akouz/HBus/HBnodeMiniPro/README.md

# Demo HBus implementation for Arduino Mini Pro

Current firmware revision 1.5 uses 69% of flash and 56% of SRAM. The demo code has 4 topics and 4 coos tasks as defined in "HBconfig.h". Development notes in "HBcommon.h".
