akouz/HBus/Devices/README.md

# HBus Devices

Power supply should be in the range 9...30V. Devices designed for +12V, but they can work from +24V supply too.

  * [Fuse](https://github.com/akouz/HBus/tree/master/Devices/01_Fuse)
  * [USB Bridge](https://github.com/akouz/HBus/tree/master/Devices/02_USB_Bridge) 
    * PC program [NodeTest](https://github.com/akouz/HBus/tree/master/NodeTest)
  * [2.1] [WiFi Gateway](https://github.com/akouz/HBus/tree/master/Devices/03_WiFi_Gateway)
    * Sketch [WiFiGw](https://github.com/akouz/HBus/tree/master/Devices/03_WiFi_Gateway/WiFiGw)
  * [3.1] [Sensor Input](https://github.com/akouz/HBus/tree/master/Devices/04_Sensor)
  * [4.1] [4-channel Relay Output](https://github.com/akouz/HBus/tree/master/Devices/05_Relay4)
  * [4.2] [4-channel N-MOSFET Output](https://github.com/akouz/HBus/tree/master/Devices/06_MOSFET4)
    * Sketch [White_LED_strip](https://github.com/akouz/HBus/tree/master/Devices/06_MOSFET4/Sketches/White_LED_strip)
  * [5.1] [Power Meter](https://github.com/akouz/HBus/tree/master/Devices/07_Power_Meter)
    * Sketch [Sole_Power_Meter](https://github.com/akouz/HBus/tree/master/Devices/07_Power_Meter/Sole_Power_Meter)
    * Sketch [HBus_Power_Meter](https://github.com/akouz/HBus/tree/master/Devices/07_Power_Meter/HBus_Power_Meter)
  * [5.2] [PIR Sensor Input with 3-channel P-MOSFET Output](https://github.com/akouz/HBus/tree/master/Devices/08_PIR_Sensor)
    * Sketch [PIR Sensor](https://github.com/akouz/HBus/tree/master/Devices/08_PIR_Sensor/PIR_Sensor)
