akouz/HBus/Devices/01_Fuse/README.md

# HBus Fuse

HBus Fuse prevents fire caused by HBus wiring. Cat5/Cat6 cables cannot safely and reliably handle current more than 3.5 A.  HBus Fuse allows a high output current power supply or a 12V battery to be connected to HBus network.

HBus Fuse has 1 input from a 12V power supply or battery, and it has 2 outputs to HBus wiring. It has 2 fuseholders for 20x5 mm fuses. Slow blow 3 A fuses are recommended. When a fuse is blown, a red LED goes lit to indicate a problem.

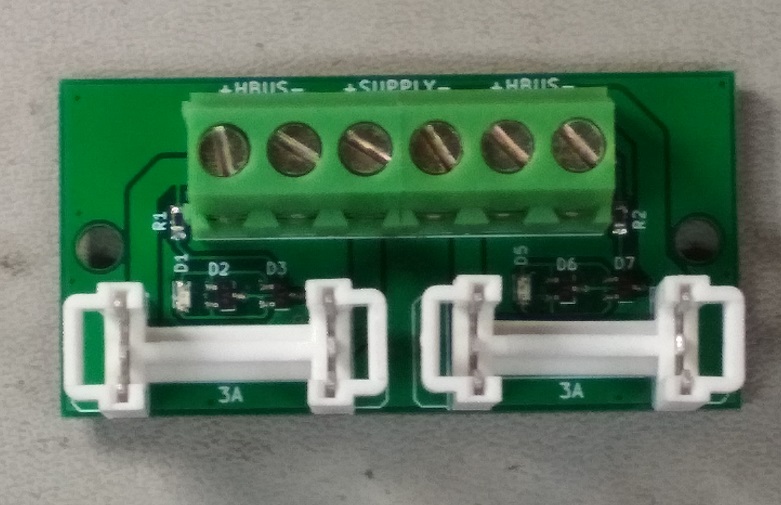
[picture p3: Devices/01_Fuse/Fuse.jpg]
Fuse_board


Assembled board.
