akouz/HBus/Devices/08_PIR_Sensor/README.md

 # HBus PIR Sensor
 
   * PIR sensor HC-SR501, or microwave radar sensor RCWL-0516, or both
   * LDR for ambient light level measurement
   * Optional 1-Wire for temperature sensors
   * Outputs:
     * 3-channel P-MOSFET output for RGB-strips with PWM control
     * Channel 1 output also can drive RGB strips with individial RGB LED control (FastLED, etc)
   * Double sided PCB 50x50 mm

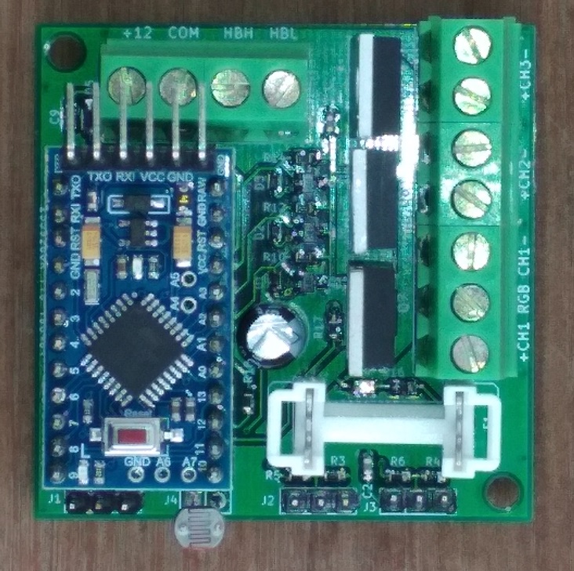
[picture p4: Devices/08_PIR_Sensor/PIR_sensor.jpg]
Assembled


Assembled board.
