akouz/HBus/Devices/06_MOSFET4/README.md

# 4-channel MOSFET Output

  * 4 galvanically isolated outputs, IRF540 MOSFETs
  * MOSFET output designed for 1 kHz PWM
  * Output supply voltage 10...30 Vdc
  * Arduino detects presence of MOSFET supply voltage
  * Optional photoresistor input for ambient light sensing
  * Optional 1-Wire bus for DS18B20 temperature sensors; also this input can be used to connect PIR detector or reed switch
  * Double sided PCB 50x70 mm

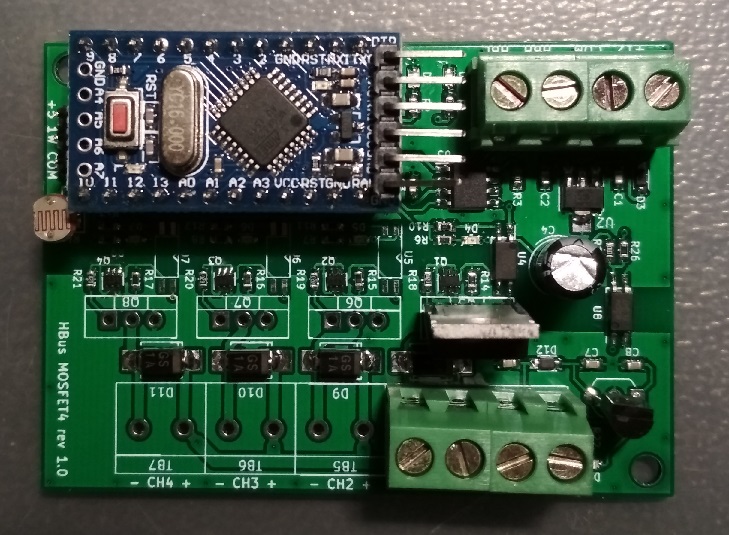
[picture p11: Devices/06_MOSFET4/MOSFET4.jpg]


Board with only one channel CH1 assembled.
