akouz/HBus/Devices/05_Relay4/README.md

# HBus 4-channel Relay

  * 4 channel relay module, current rating 10 A per channel
  * Current transformer input to control state of one load
  * Mains input to control presense of mains voltage, as well as to switch relays close to mains zero-crossing 
  * Relay test input for calibration relay ON/OFF time
  * PCB 85x100 mm with provisions for [DIN rail clips](https://www.ebay.com.au/sch/i.html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)
  
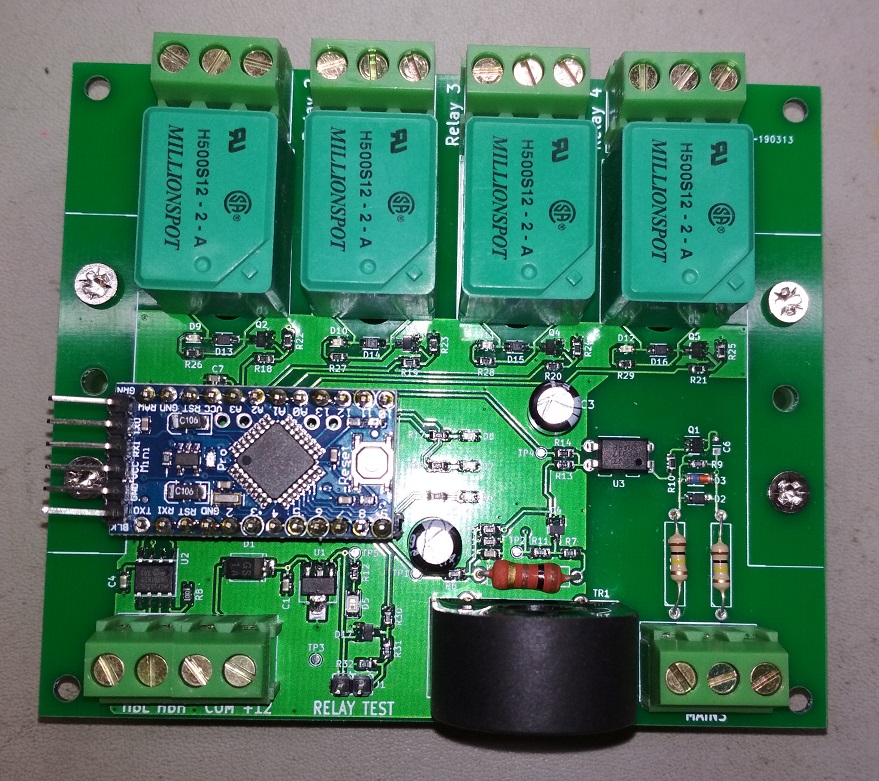
[picture p12: Devices/05_Relay4/Relay4.jpg]
Assembled Relay4
