akouz/HBus/Devices/04_Sensor/README.md

# HBus Sensor

A universal HBus sensor module for various applications. It includes:
  * 1-Wire bus for Dallas DS18S20 temperature sensors.
  * Temperature/humidity/pressure sensor BME280, or any other I2C sensor powered by 3.3V.
  * Four inputs for resistive sensors, such as:
    * [precision interchangeable NTC thermistors](https://www.littelfuse.com/products/temperature-sensors/leaded-thermistors/interchangeable-thermistors/standard-precision-pt/pt222j2.aspx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)
    * photoresistors
    * soil moisture sensors
    * water leakage sensors
    * intrusion detectors 
    * etc

Double sided PCB 50x50 mm.
