akouz/HBus/Devices/07_Power_Meter/HBus_Power_Meter/README.md

# Sketch HBus Power Meter
#### rev 1.0

Measures total household power (import/export) and power produced by solar station. Results output to 1m long RGB LED strip and broadcasted to HBus.
