akouz/HBus/Devices/03_WiFi_Gateway/WiFiGw/README.md

# Sketch WiFiGw.ino

Current rev 1.10

## Encryption

File "cipher.h" generated by [NodeTest](https://github.com/akouz/HBus/tree/master/NodeTest), it stores flash keys. EEPROM keys  and unencrypted access rights should be set by NodeTest during initialisation (command SECURITY, see [HBus protocol](https://github.com/akouz/HBus/tree/master/Protocol)).

## WiFi connection

In WiFi_Gateway.ino enter your WiFi network credentials:

> const char* ssid     = "your_ssid";

> const char* password = "your_password";

In case of lost WiFi connection, sketch tries to restore it, see **coos_task_wifi_reconnect()**.

## MQTT broker

In WiFi_Gateway.ino enter MQTT broker credentials:

> const char* mqtt_url = "your_mqtt_broker";

> const char* mqtt_username = "";

> const char* mqtt_password = "";

If user name or password left blank then Gateway will not use them.

In case of lost connection, sketch will try to re-connect to MQTT broker, see **coos_task_mqtt_reconnect()**.

Sketch keeps MQTT connection alive by sending a short message to broker every 5 sec, see **coos_task_mqtt_ping()**.

## MQTT-SN to MQTT conversion

Gateway reads HBus MQTT-SN messages from the bus, converts them into MQTT messages and sends to the MQTT broker, see **hbus_msg_to_mqtt()** in **HBus.cpp**. Duiring conversion Gateway replaces **TopicId** by a topic name. 

The topic name of the outgoing message consists of **topic_base** and **TopicName**. List of registered **TopicId**s stored in EEPROM, list of registered **TopicName**s stored in SPIFFS. 

For example,  lets assume **topic_base**="HBus",  **TopicName**="topic0" is registered as **TopicId**=100 (or 0x0064). If a node broadcasts  HBus message **PUBLISH**:

> 0C 00 11 00 64 0E 7B 01  {val:3} 

then Gateway converts it to MQTT message with payload **{val:3}** and topic name "**HBus/topic0**" and sends it to the broker.

## MQTT to MQTT-SN conversion

Gateway is subscribed to topics **topic_base**/#. Messages from MQTT broker to that topic will be processed as follows:
  * **topic_base** and "/" removed
  * if the remining **TopicName** is registered by Gateway then corresponding **TopicId** is used to make MQTT-SN message
  * resulting MQTT-SN message broadcasted to HBus

HBus nodes must register their **TopicName**s using **REGISTER** messages, see [HBus protocol](https://github.com/akouz/HBus#mqtt-sn-mode-broadcast-messages). Gateway detects **REGISTER** messages and automaticaly updates its list of registered **NodeName - NodeId** pairs.

## Time service

Every hour sketch requests time from a NTP server. When respond received,  Gateway broadcasts HBus a MQTT-SN message to the default TopicId=1 and sends a message to MQTT broker with default TopicName="time" and with the following payload (sample):

> {atime:1558391178, tz:570, daysec:28578, hr:7, min:56}

where 
  * atime - UTC time, seconds since 00:00:00 of 01/01/2001
  * tz - time zone, offset in minutes from UTC
  * daysec - second since 00:00:00 of current day
  * hr - hour of the day
  * min - minute of the hour

## HBus voltage

Gateway regularly measures HBus supply voltage and sends results to MQTT topic **hb/volt** and to HBus

## CO2 sensor MH-Z19B

Sensor powered by +5V rail. Sensor PWM output connected to D13 (eg GPIO13, Wemos D1 pin 7). After power-up Gateway takes no measurements for 1 min. Gateway outputs measured CO2 level (in ppm) to topic **gw/CO2**

## BMx280 sensor

BMP280 or BME280 sensor connected via I2C bus (SCL=D5, SDA=D4). If connected, sketch broadcasts sensor results to the following MQTT and HBus topics:
  * **gw/temp** - temperature, C
  * **gw/press** - atmospheric pressure, mbar
  * **gw/hum** - relative humidity, % (only if BME280 connected)
  
## OLED display

Sketch outputs harware and software revision, current connecion status data and measurement results via I2C to a 128x32 OLED display driven by SSD1306.
