akouz/HBus/NodeTest/Doc/pic3_1.png

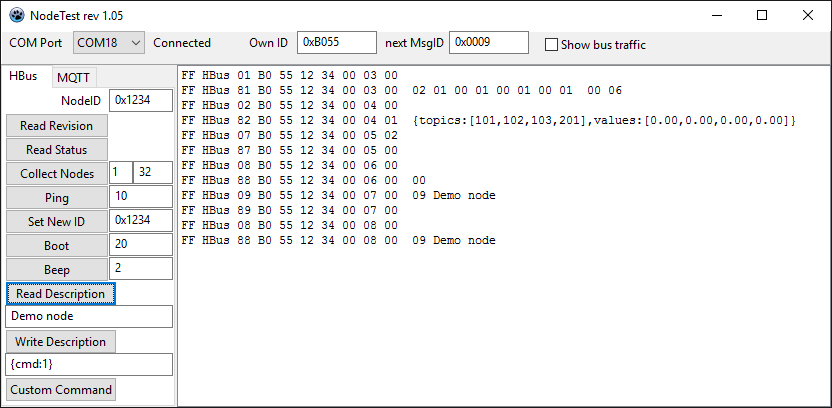
NodeTest/Doc/pic3_1.png
