akouz/HBus/NodeTest/Doc/pic4_1.png

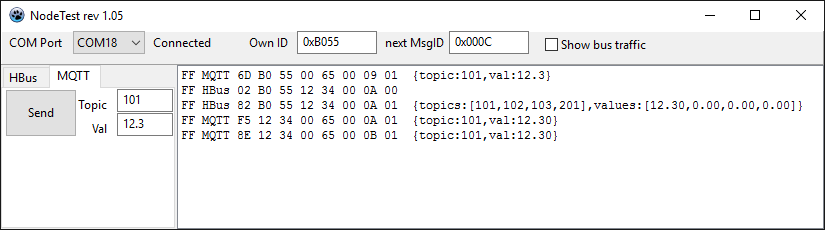
NodeTest/Doc/pic4_1.png
