akouz/HBus/Devices/03_WiFi_Gateway/WiFi_Gateway_SCH_rev_1_4.pdf

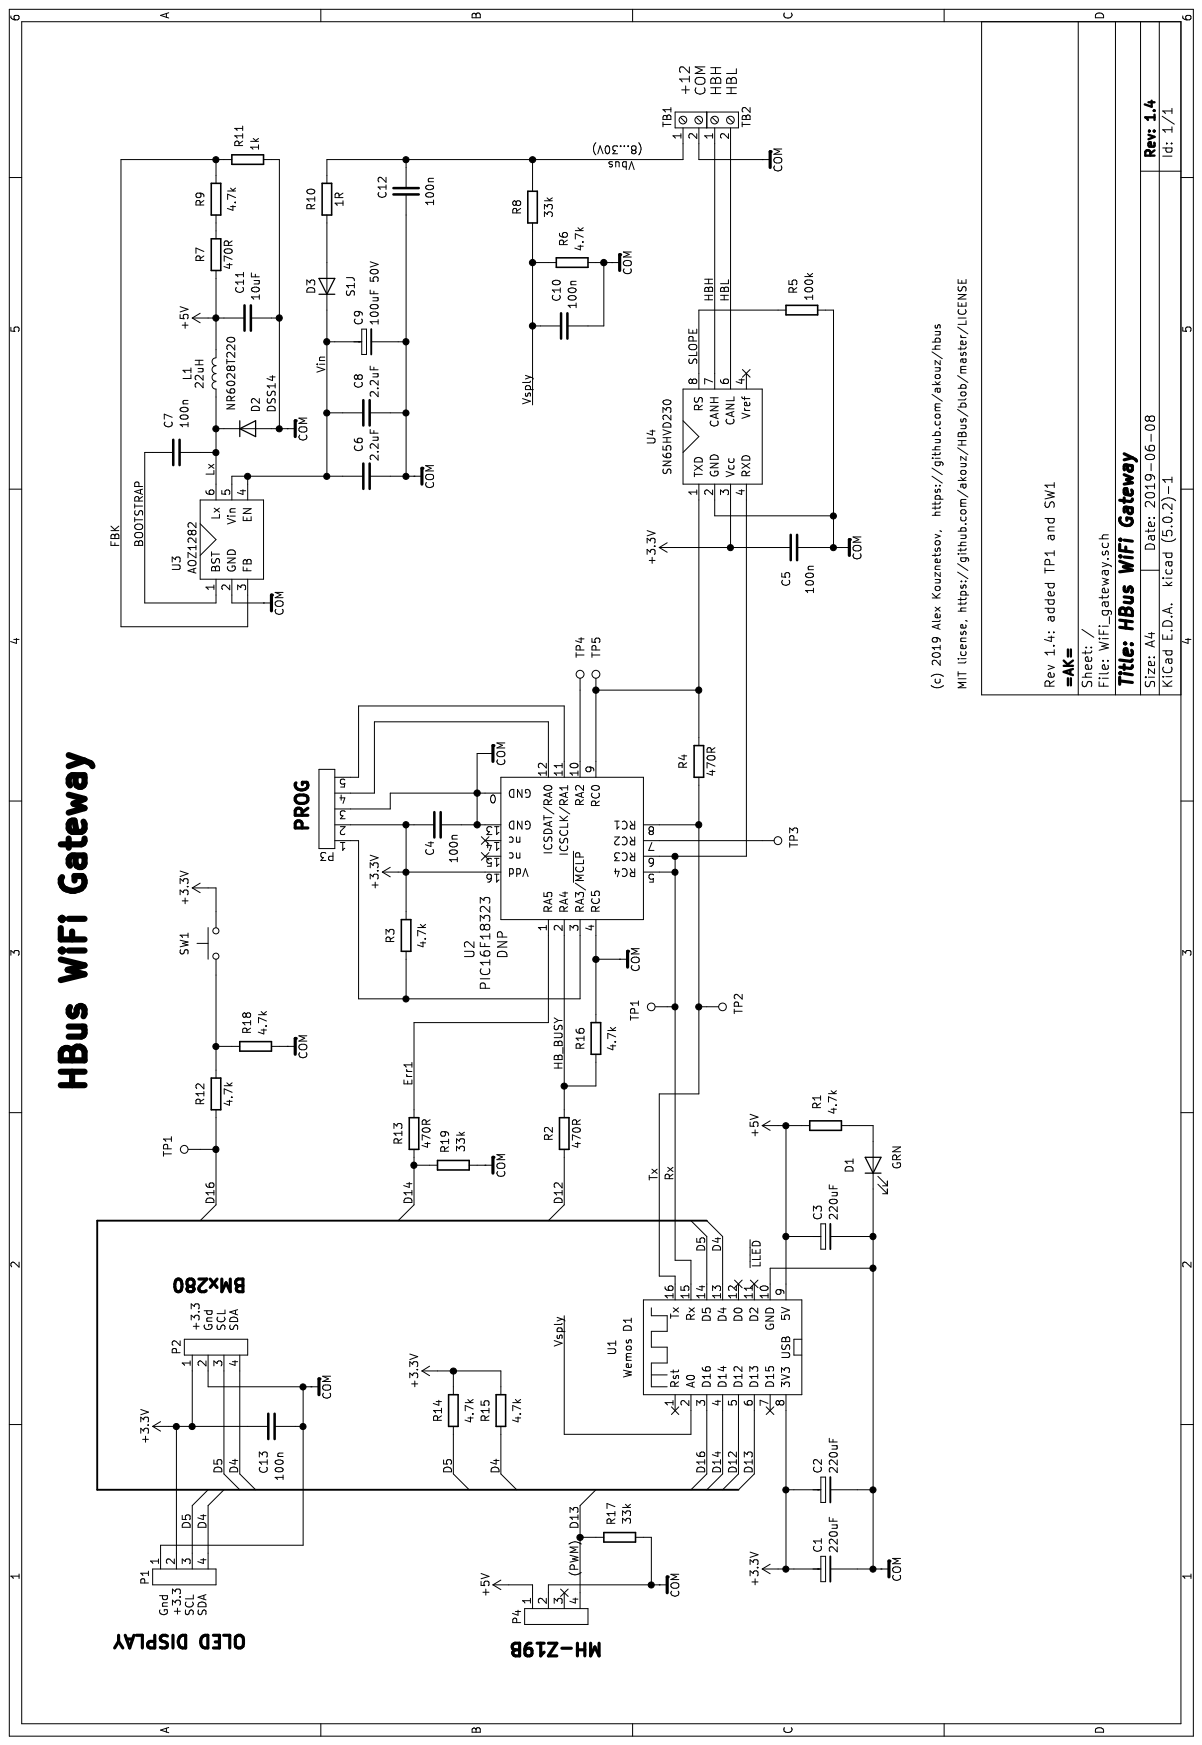
[picture p20: page 1]
