akouz/HBus/Devices/08_PIR_Sensor/PIR_Sensor_SCH_rev_1_1.pdf

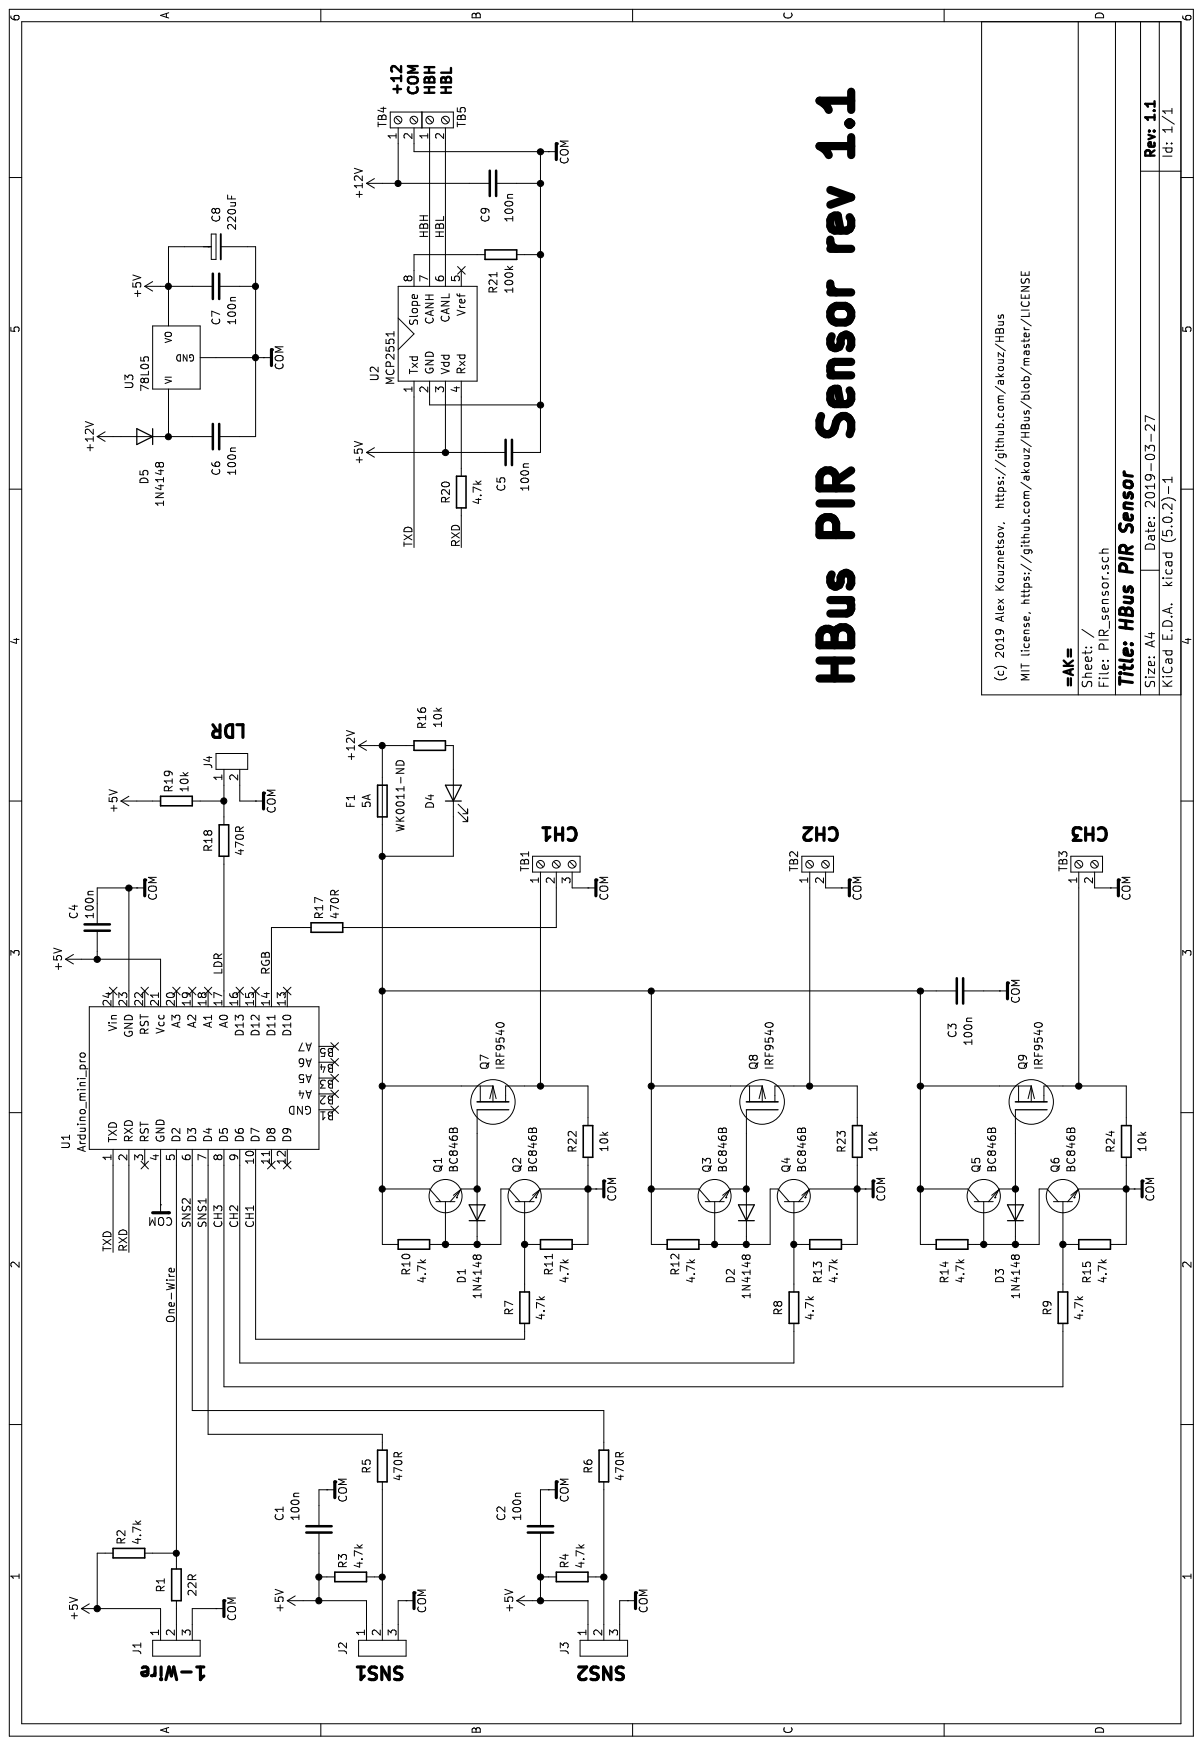
[picture p21: page 1]
