akouz/HBus/Devices/01_Fuse/Fuse_SCH_rev_1_0.pdf

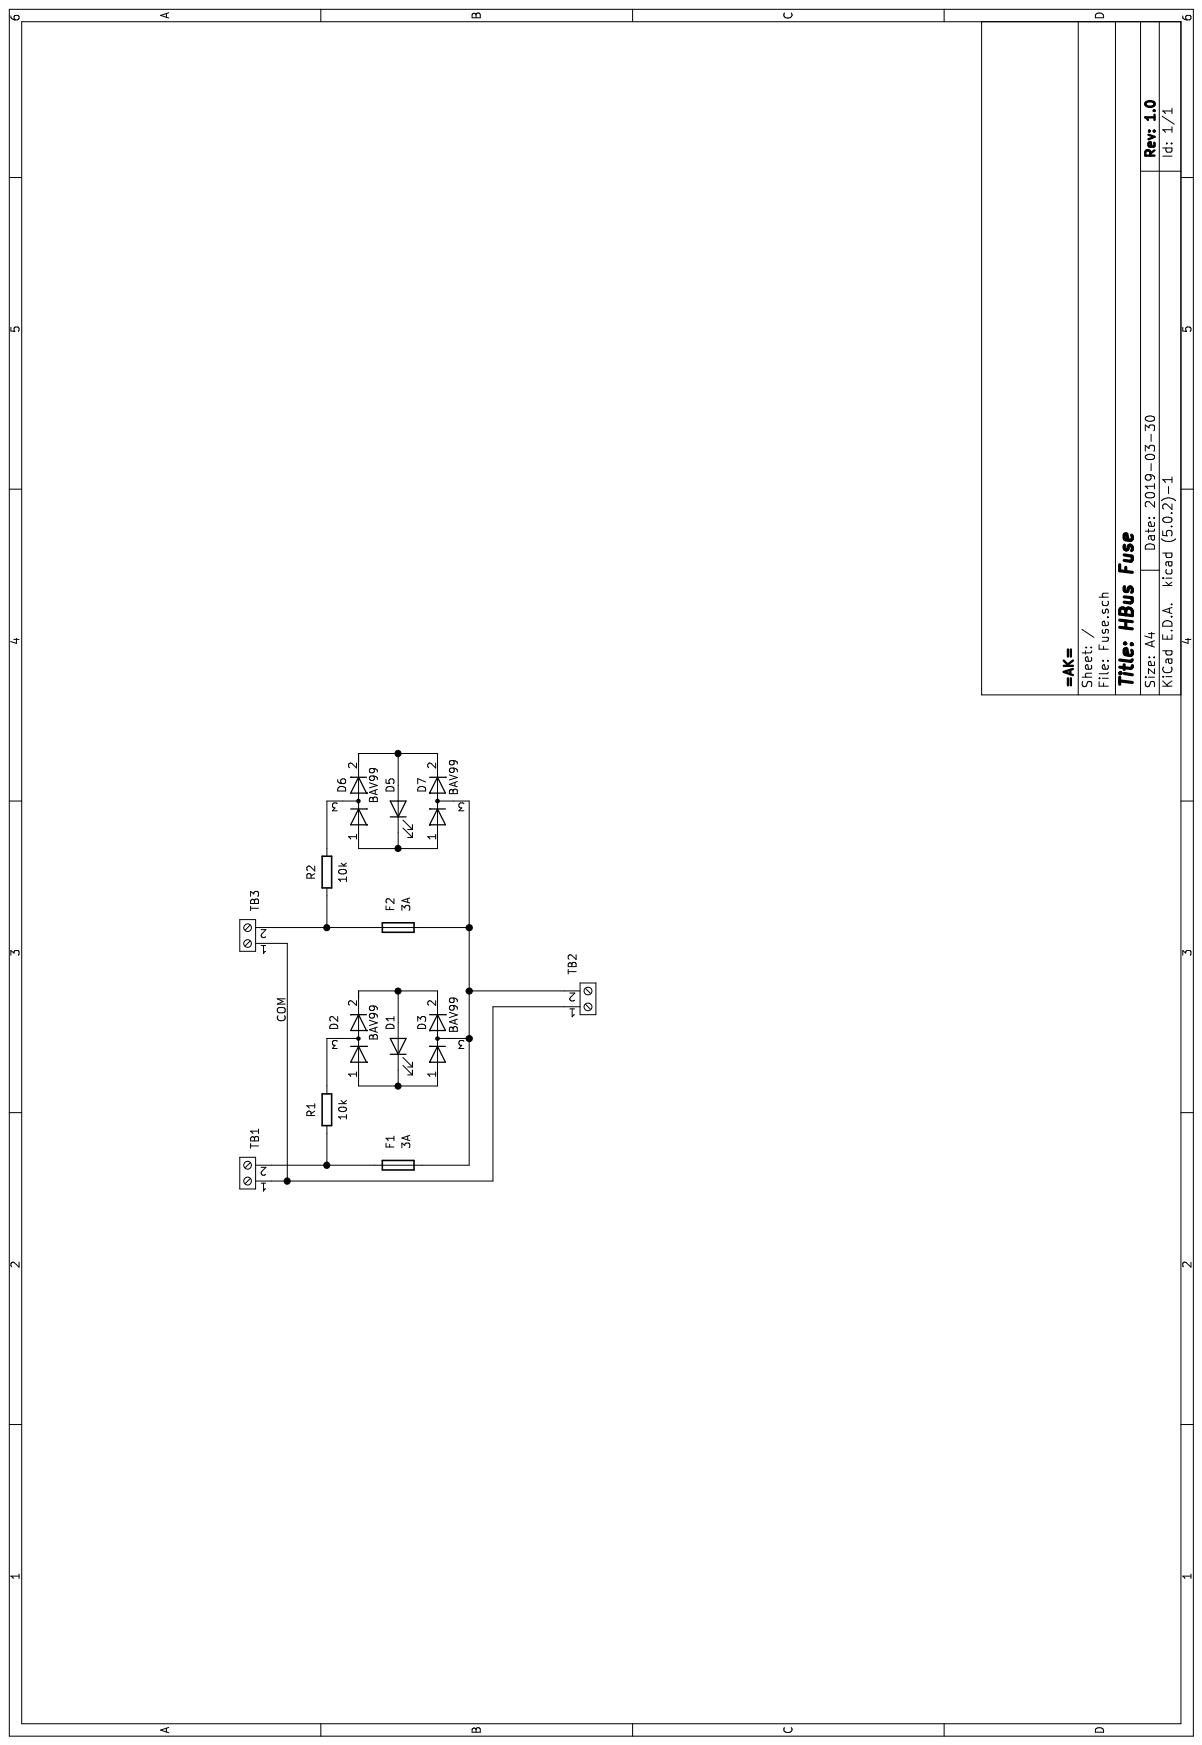
[picture p22: page 1]
