akouz/HBus/Devices/06_MOSFET4/MOSFET4_SCH_rev_1_0.pdf

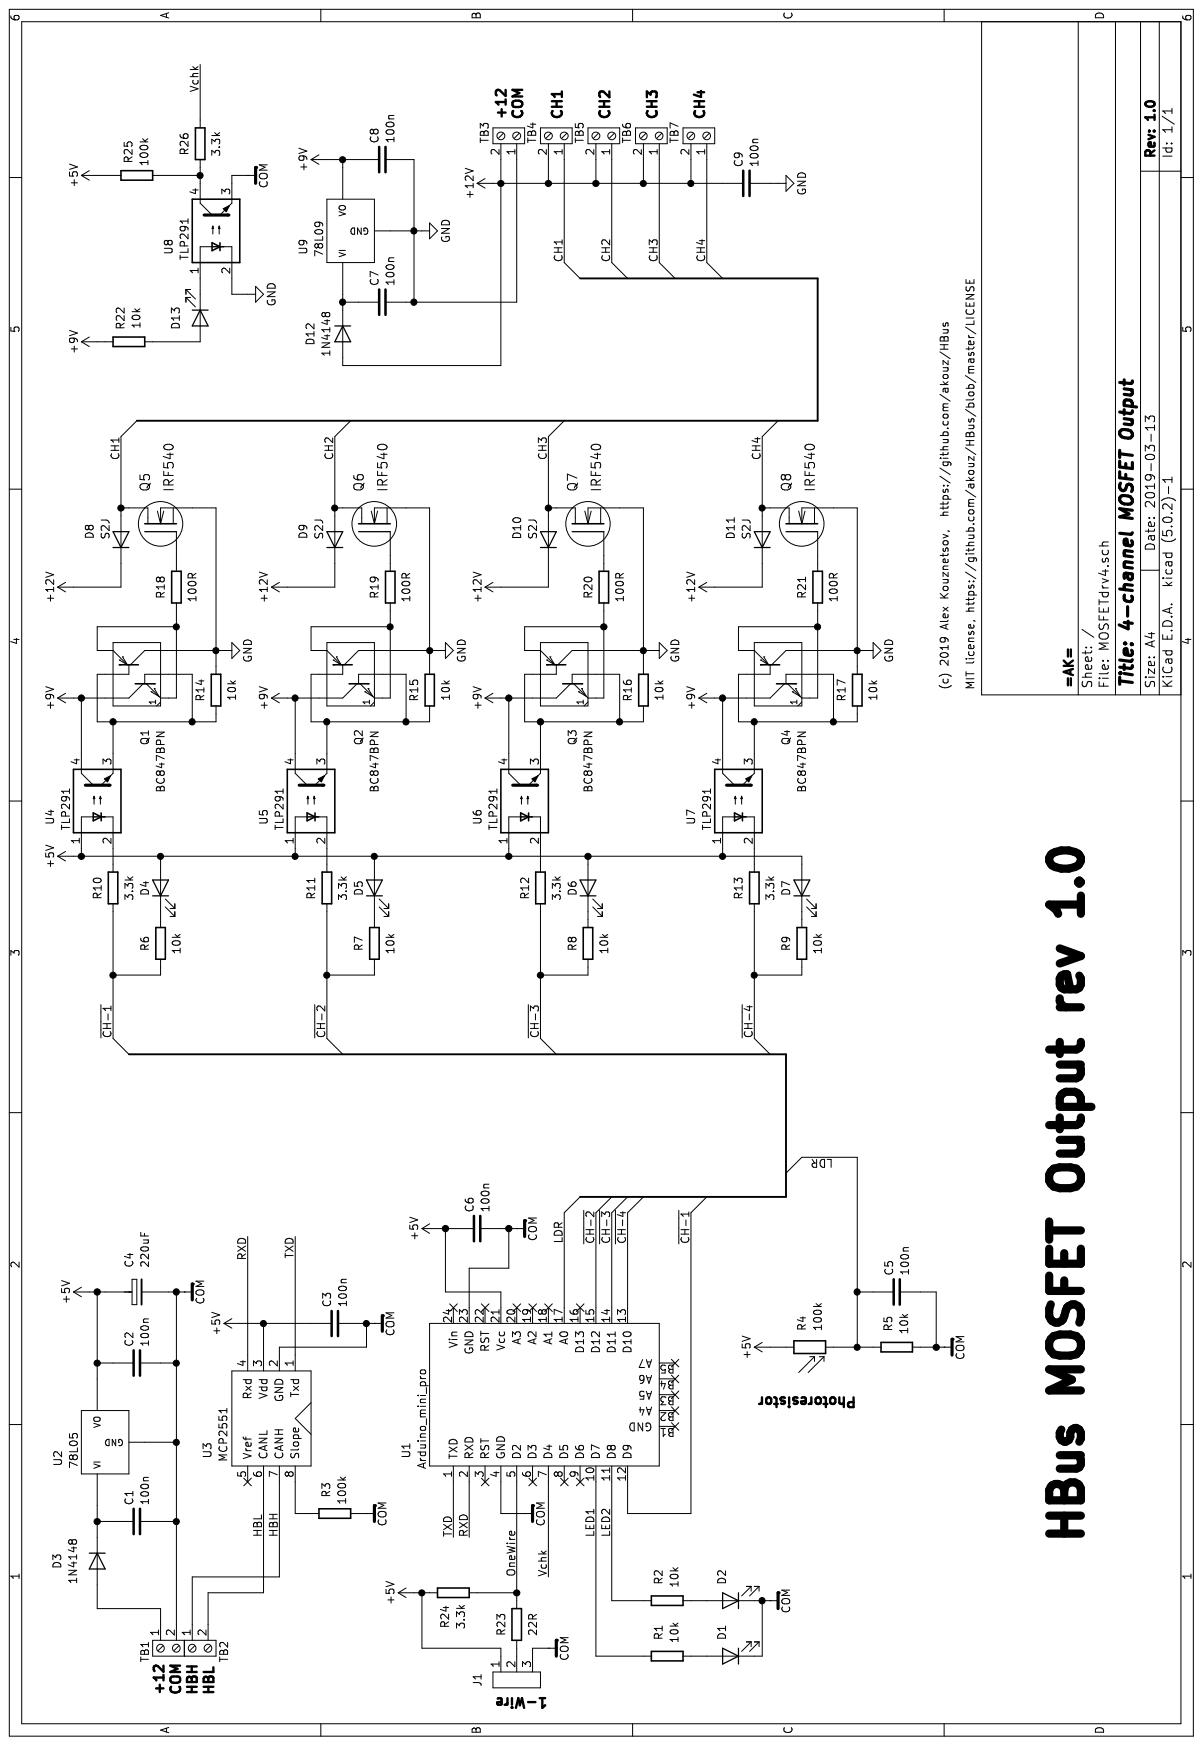
[picture p23: page 1]
