akouz/HBus/Devices/07_Power_Meter/Power_Meter_SCH_rev_1_1.pdf

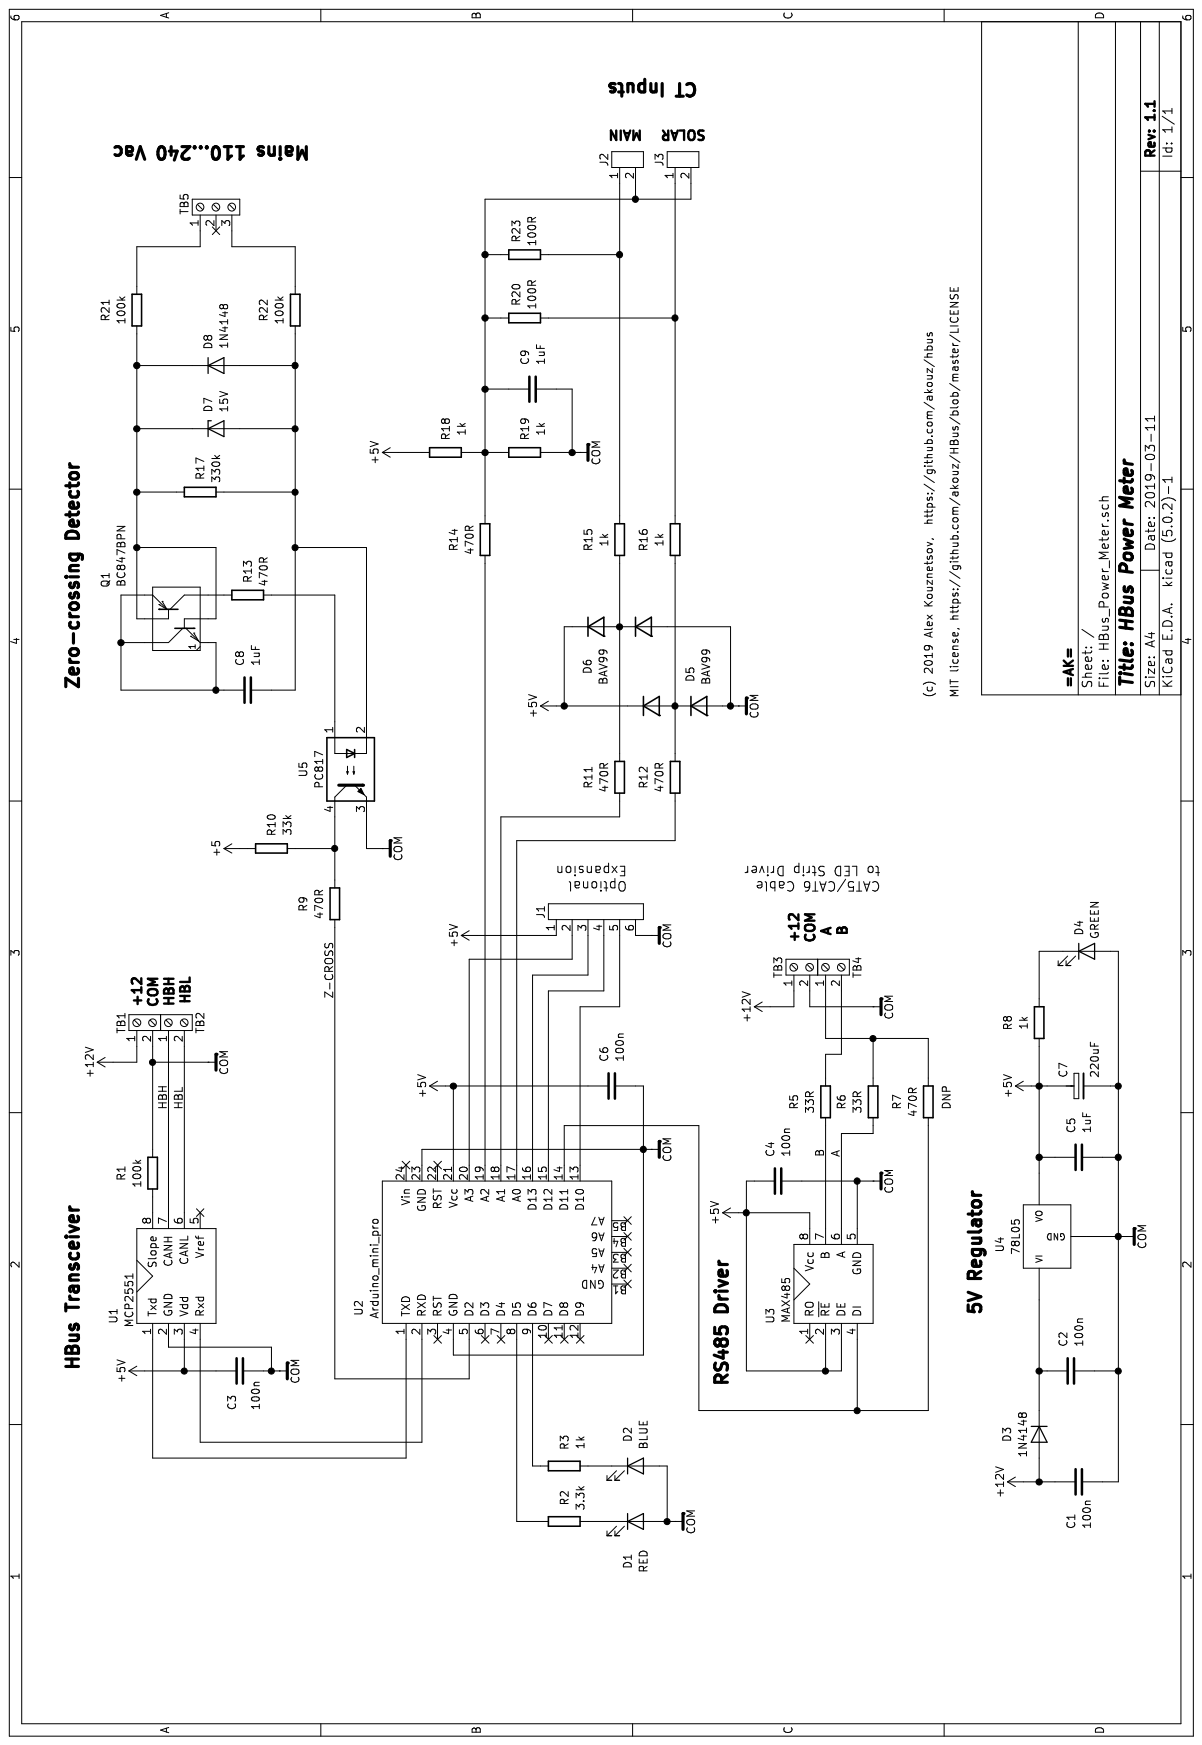
[picture p24: page 1]
