akouz/HBus/Devices/04_Sensor/Sensor_SCH_rev_1_0.pdf

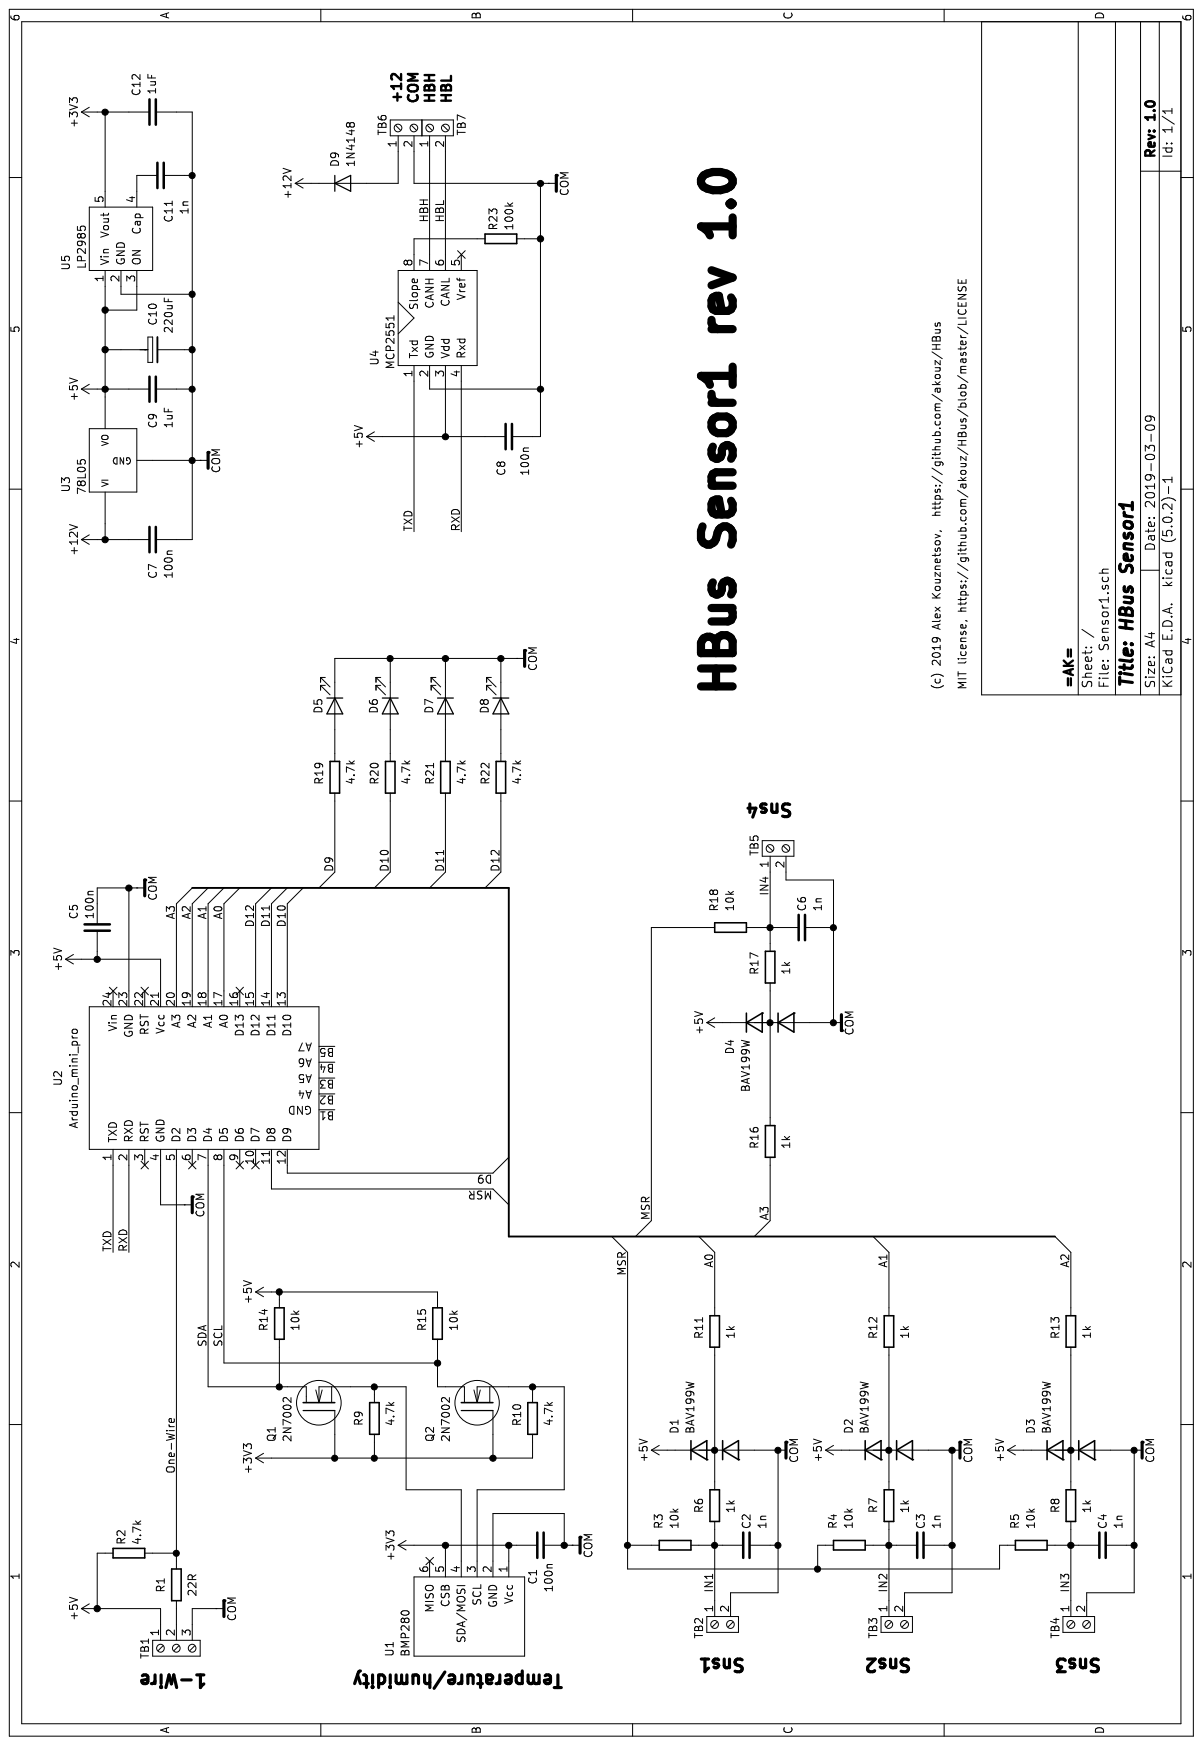
[picture p25: page 1]
