akouz/HBus/Devices/05_Relay4/Relay4_SCH_rev_1_0.pdf

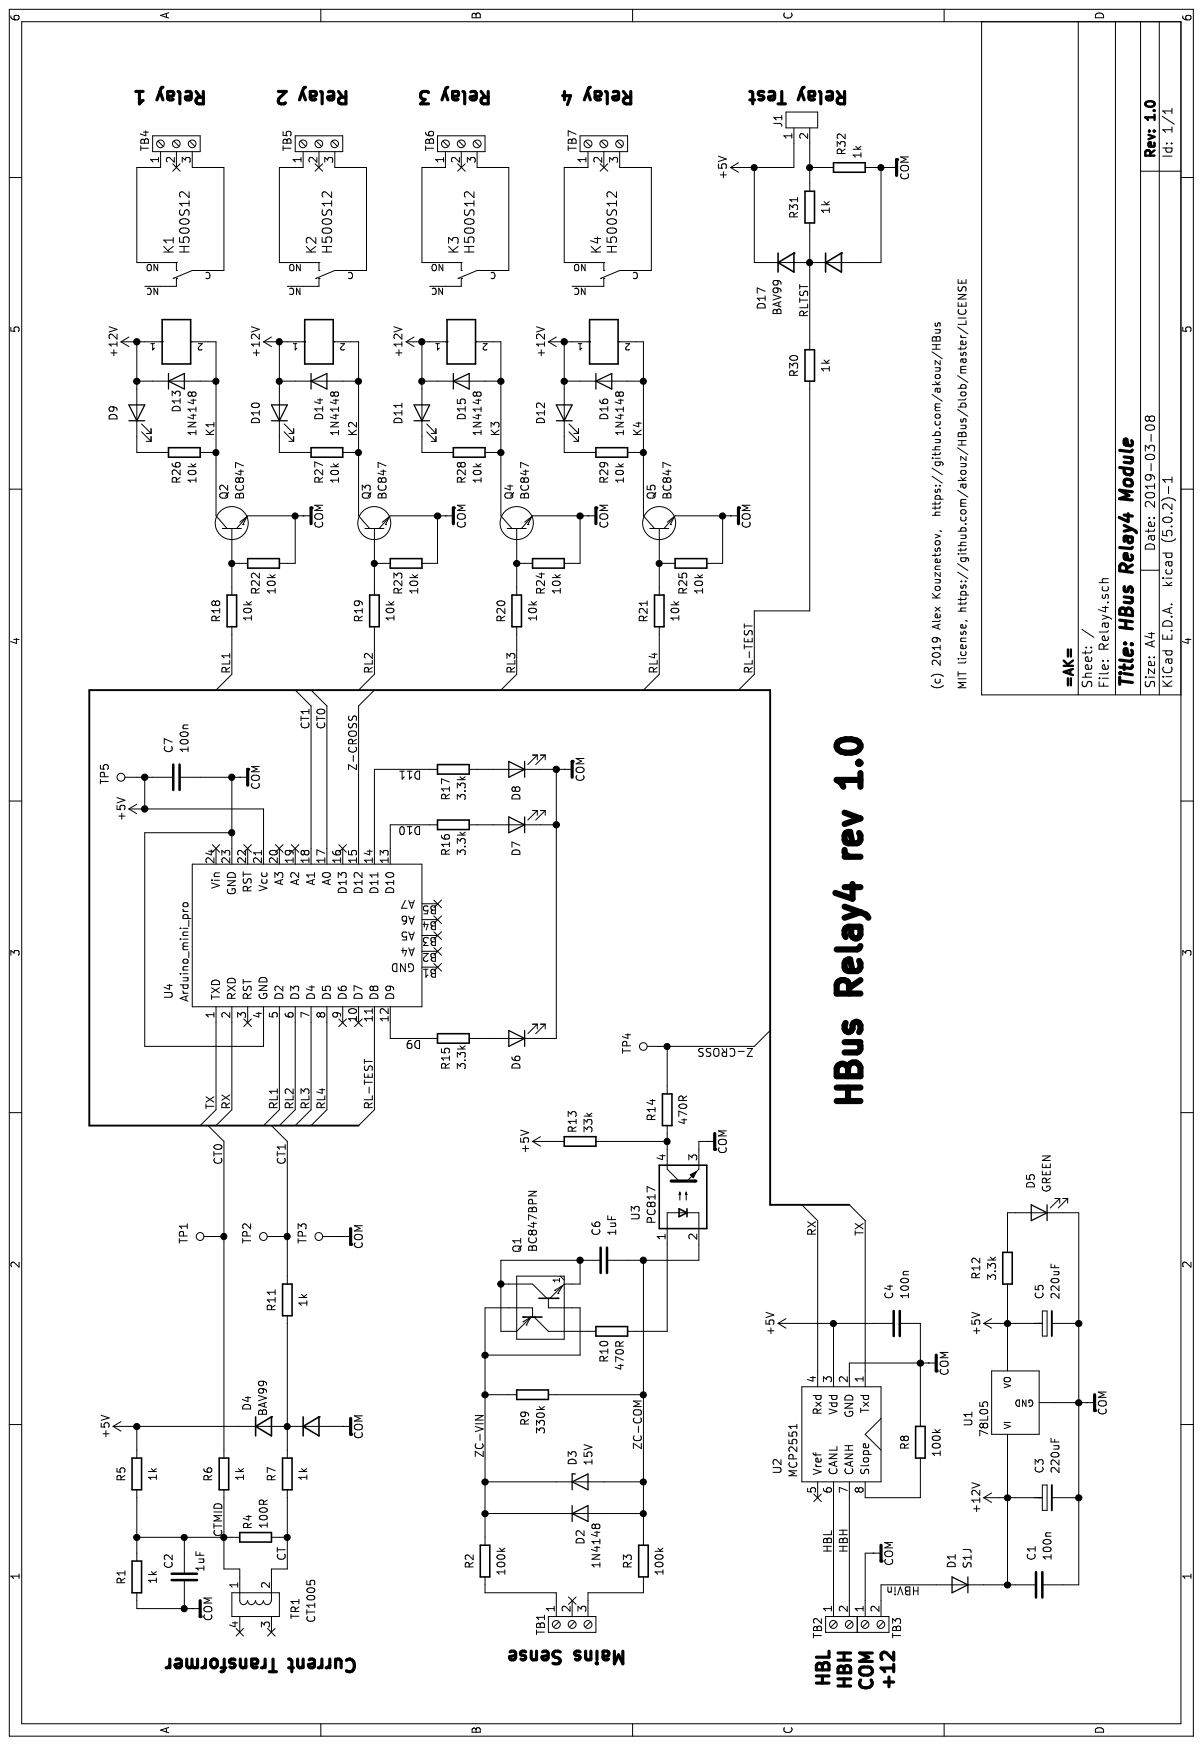
[picture p26: page 1]
