akouz/HBus/Devices/07_Power_Meter/RGB_Strip_Driver_SCH_rev_1_1.pdf

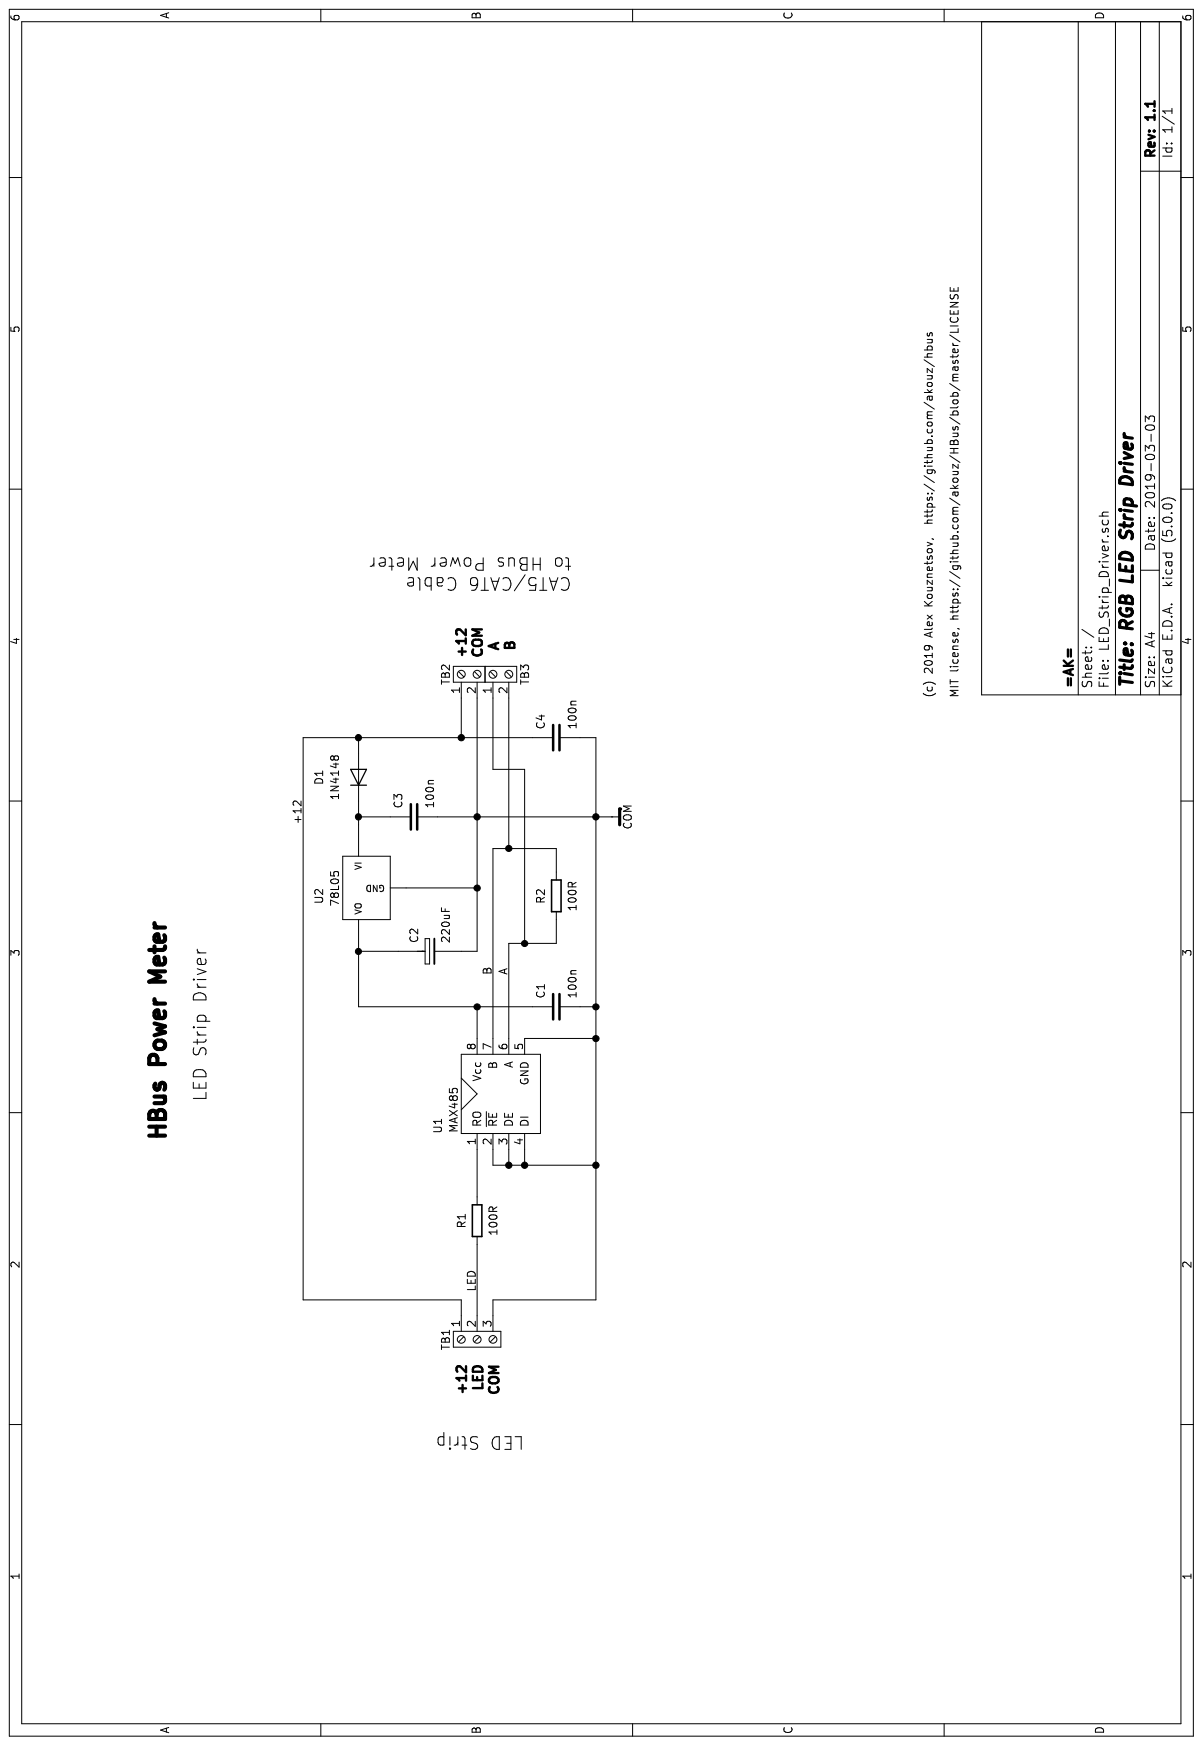
[picture p27: page 1]
