akouz/HBus/Devices/02_USB_Bridge/USB_bridge_SCH_rev_1_1.pdf

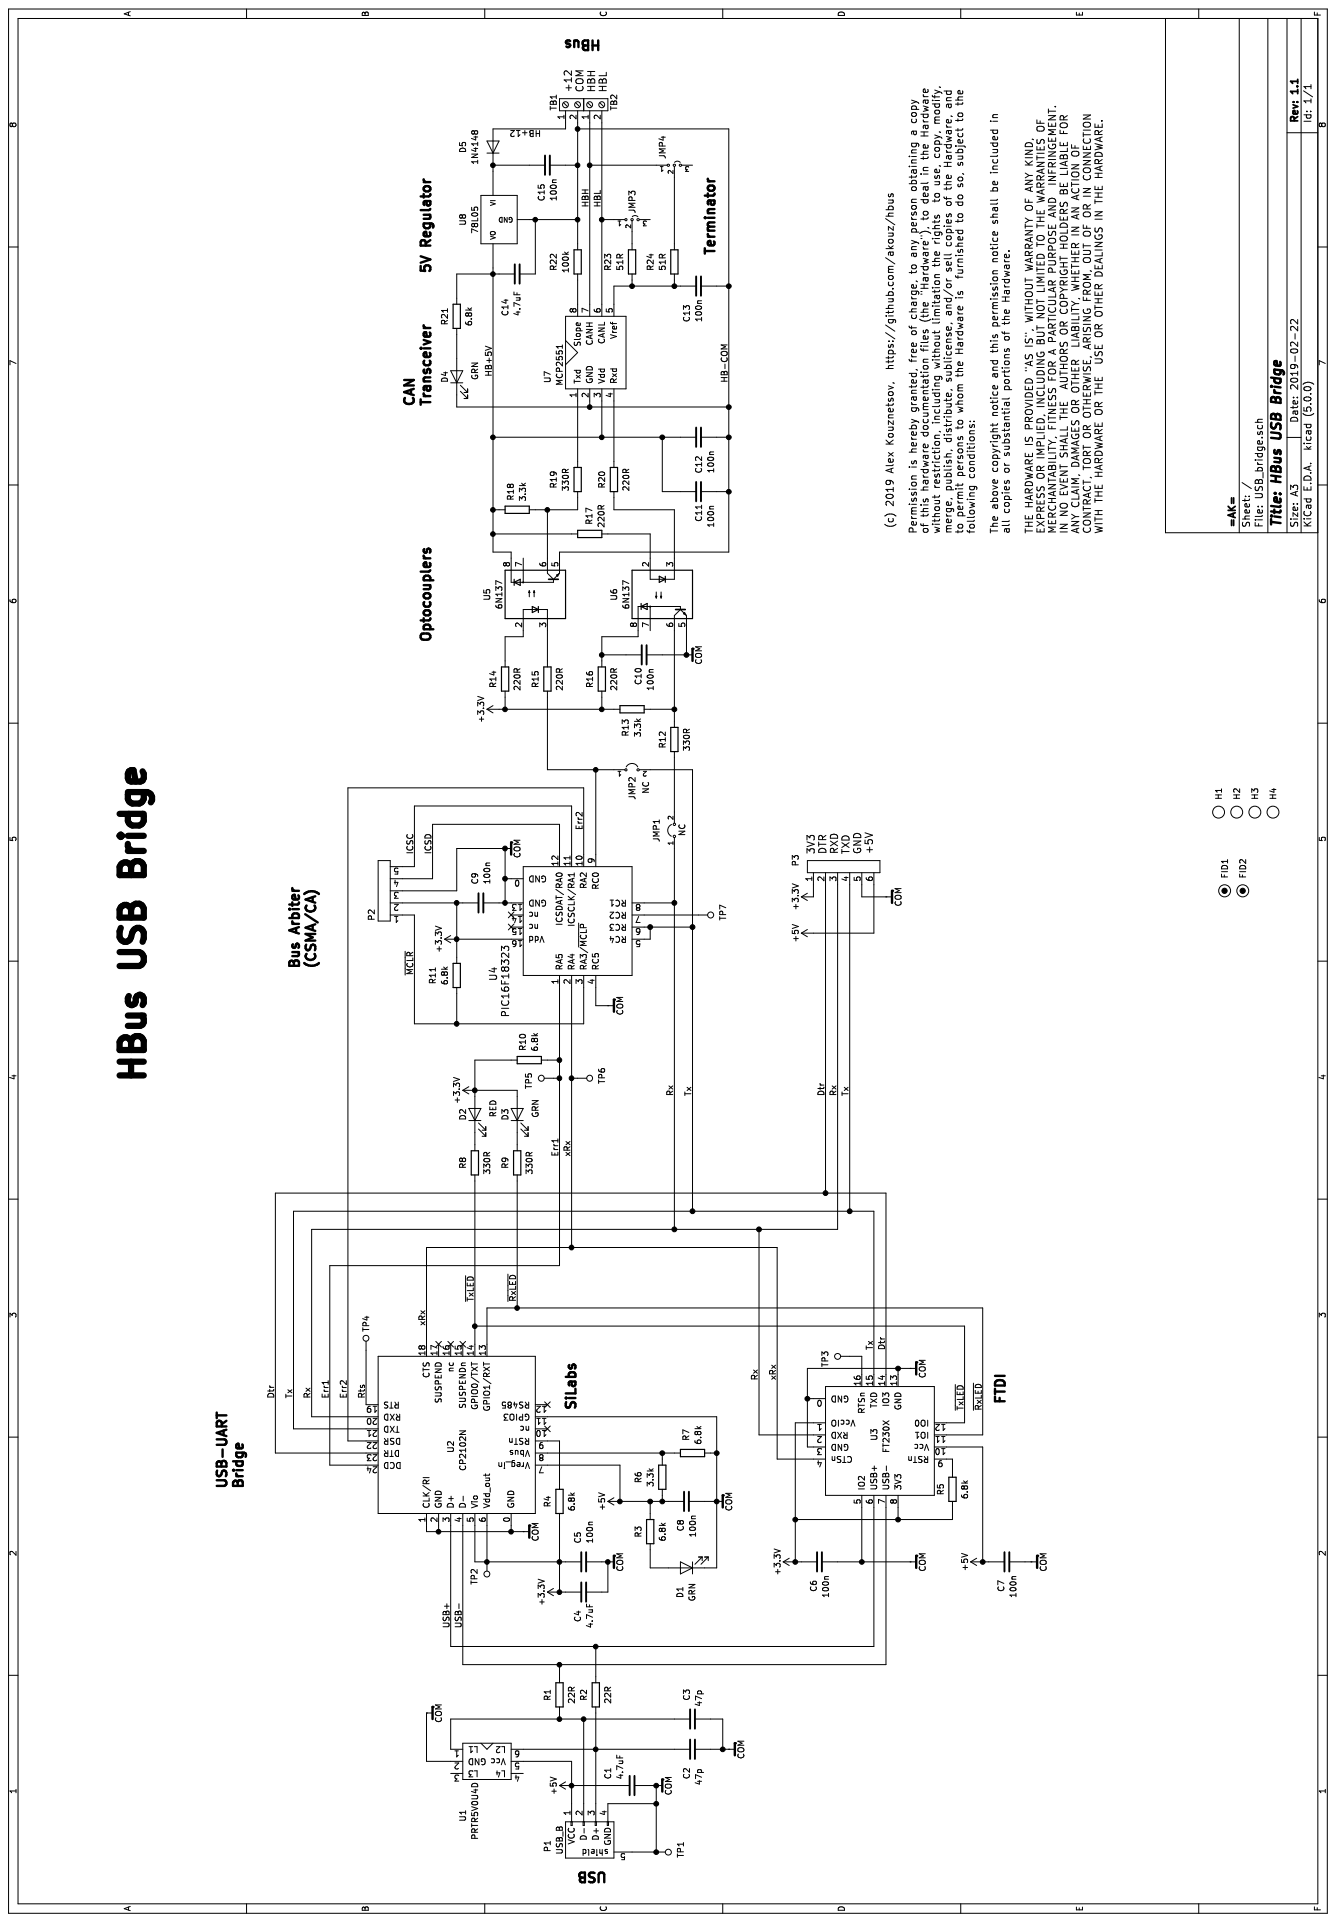
[picture p28: page 1]
