akouz/HBus/Devices/03_WiFi_Gateway/WiFi_Gateway_SCH_rev_1_1.pdf

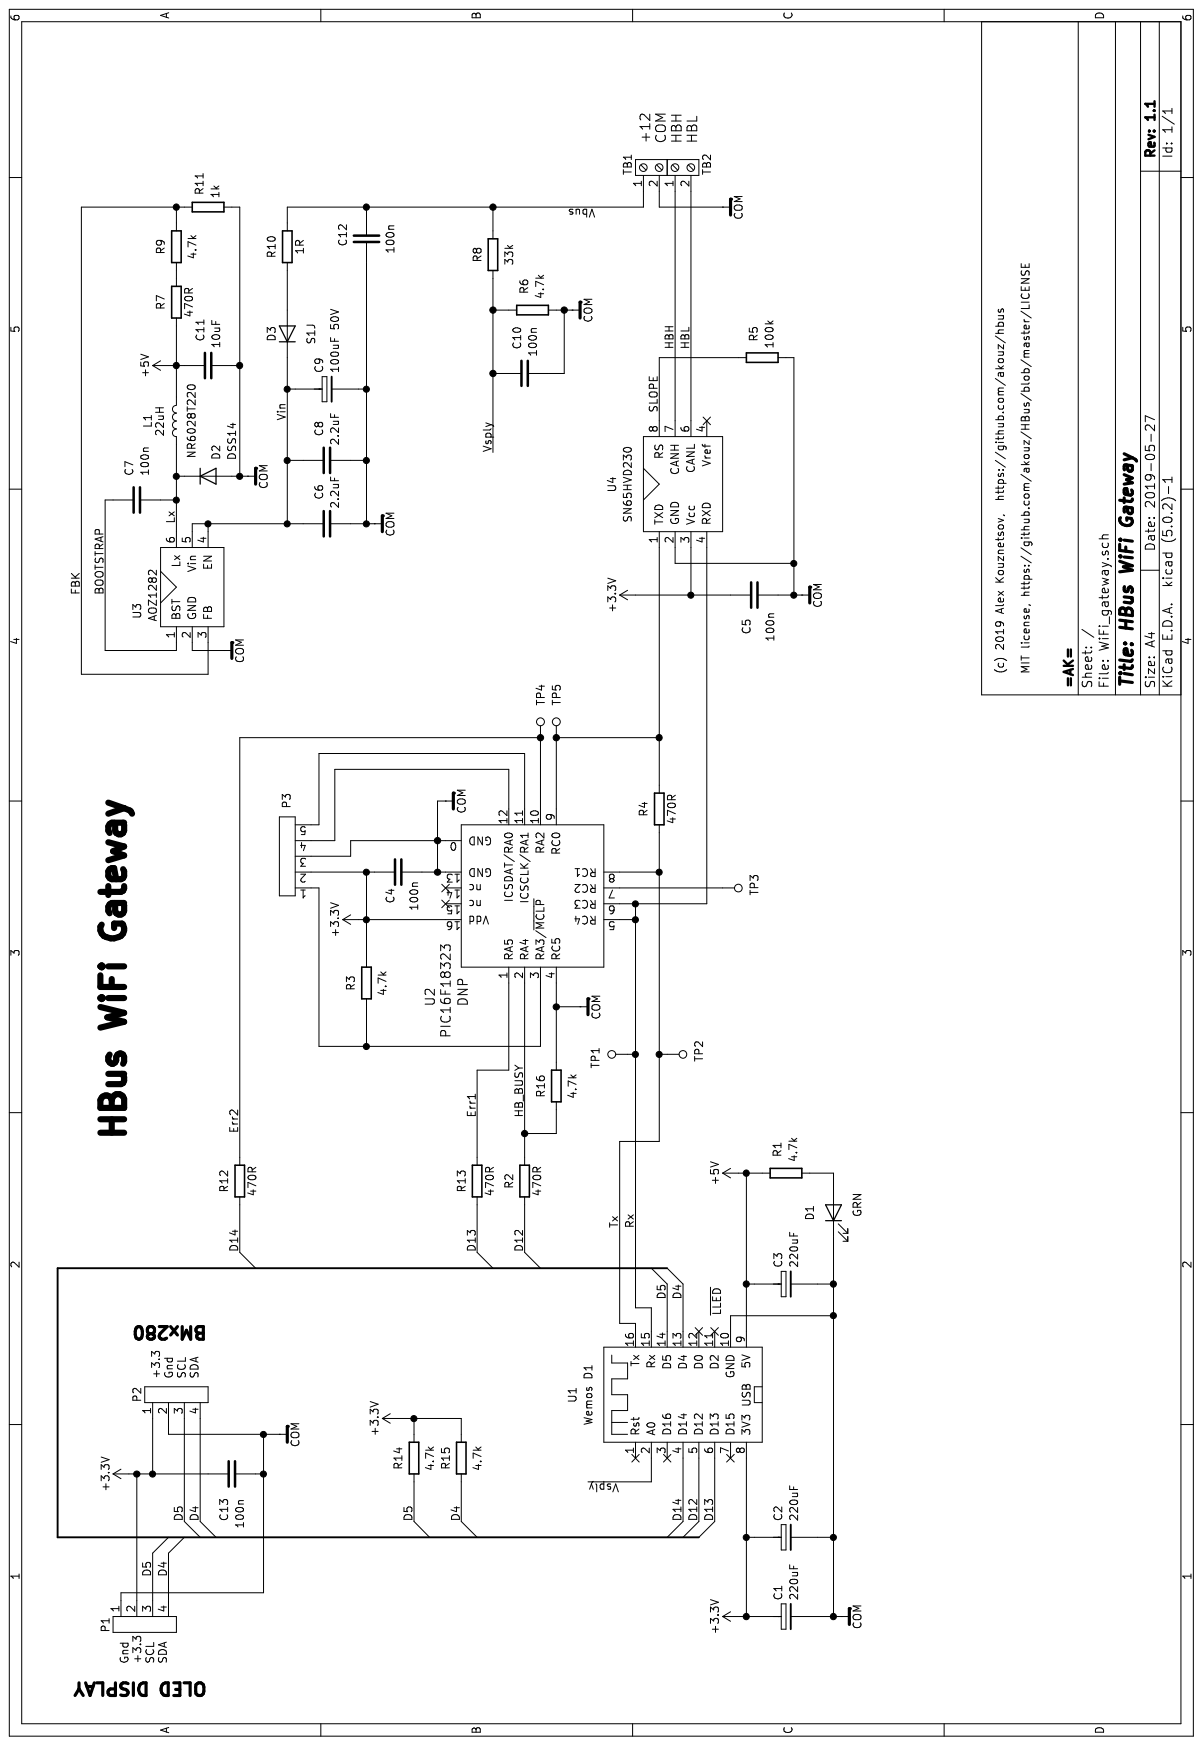
[picture p29: page 1]
