akouz/HBus/HBnodeMiniPro/HBus.cpp

/*
 * File     HBus.cpp
 
 * (c) 2019 Alex Kouznetsov,  https://github.com/akouz/hbus
 *
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
 * THE SOFTWARE IS PROVIDED "AS IS", WITHOUT WARRANTY OF ANY KIND, EXPRESS OR
 * IMPLIED, INCLUDING BUT NOT LIMITED TO THE WARRANTIES OF MERCHANTABILITY,
 * FITNESS FOR A PARTICULAR PURPOSE AND NONINFRINGEMENT. IN NO EVENT SHALL THE
 * AUTHORS OR COPYRIGHT HOLDERS BE LIABLE FOR ANY CLAIM, DAMAGES OR OTHER
 * LIABILITY, WHETHER IN AN ACTION OF CONTRACT, TORT OR OTHERWISE, ARISING FROM,
 * OUT OF OR IN CONNECTION WITH THE SOFTWARE OR THE USE OR OTHER DEALINGS IN THE
 * SOFTWARE.
 */

//##############################################################################
// Inc
//##############################################################################

#include "HBus.h"
#include "HBcipher.h"

//##############################################################################
// Var
//##############################################################################

uchar hb_pause_cnt;

//##############################################################################
// Func
//##############################################################################

// ========================================
// Clear receiver
// ========================================
void clr_rx(void)
{
    while (Serial.available())
    {
        hb_pause_cnt = 0;
        Serial.read();  // clear
    }
}
// ========================================
// Dispose tx message
// ========================================
void  finish_tx(hb_tx_msg_t* msg)
{
    if (msg)
    {
        msg->busy = 0;
        msg->valid = 0;
        Serial.flush();
    }
}
// =============================================================================
// HBus task: receieve and decode messages, send HBus reply or prompt MQTT data
// =============================================================================
void coos_task_HBus_rxtx(void)
{
    int val;
    static uchar res;
    static uchar tmout;
    static hb_msg_t* rxmsg;
    static hb_tx_msg_t* txmsg;
    COOS_DELAY(10);
    // ---------------------------
    // loop
    // ---------------------------
    while(1)
    {
        COOS_DELAY(1);
        // -----------------------------------------------
        // Process incoming HBus messages
        // -----------------------------------------------
        while (Serial.available())
        {
            hb_pause_cnt = 0;
            val = Serial.read();
            if ((HBcmd.ignore_traffic == 0) && (val >= 0))
            {
                // --------------------------------------
                // if message completed and crc matched
                // --------------------------------------
                rxmsg = HBrxtx.rx((uchar)val);
                if (rxmsg)
                {
                    if (HBrxtx.flag.seed == 0) // first received message
                    {
                        HBrxtx.flag.seed = 1;
                        node_seed = (uint)millis(); // randomise
                        if (pup_cnt < (node_seed | 0xF00D))  // EEPROM endurance 100k write cycles
                        {
                            //EEPROM.write(EE_SEED, (uchar)(node_seed >> 8));
                            //EEPROM.write(EE_SEED+1, (uchar)node_seed);
                            EEPROM.put(EE_SEED, node_seed);
                        }
                    }
                    // --------------------------------
                    // process HBus message
                    // --------------------------------
                    if (rxmsg->hb)
                    {
                        txmsg = HBcmd.process_rx_cmd(rxmsg);
                        // --------------------------
                        // if reply required
                        // --------------------------
                        if ((txmsg) && (txmsg->encrypt)) // if message to be encrypted
                        {
                            HBcipher.encrypt(txmsg->buf, txmsg->len);
                        }
                        HBrxtx.rtr_cnt = 0;
                        while (txmsg)
                        {
                            digitalWrite(LED, HIGH);
                            // -----------------
                            // postpone transmission in first run
                            // -----------------
                            COOS_DELAY(10*txmsg->postpone); // slot is 10 ms
                            txmsg->postpone = 0;
                            clr_rx();
                            if ((HBrxtx.rtr_cnt++ > 2) || (txmsg->len < 8))
                            {
                                finish_tx(txmsg); // bad message
                                txmsg = NULL;
                            }
                            // -----------------
                            // transmit
                            // -----------------
                            if (txmsg)
                            {
                                // ------------
                                // ensure bus is not busy
                                // ------------
                                tmout = 0;
                                HBrxtx.priority = 0xFF;
                                while (hb_pause_cnt < 2)
                                {
                                    COOS_DELAY(1);
                                    clr_rx();           // receiver must be empty
                                    if (++tmout > 200)  // time-out 200 ms
                                    {
                                        finish_tx(txmsg);
                                        txmsg = NULL;
                                        break;
                                    }
                                }
                                // ------------
                                // transmit and check echo
                                // ------------
                                if ((txmsg) && (hb_pause_cnt >= 2))
                                {
                                    res = HBrxtx.start_tx(txmsg);
                                    if (OK == res)
                                    {
                                        res = NOT_READY;
                                        tmout = 0;
                                        while (NOT_READY == res)
                                        {
                                            COOS_DELAY(1);
                                            res = HBrxtx.tx(&hb_pause_cnt);
                                            if (++tmout > 200)  // time-out 200 ms
                                            {
                                                finish_tx(txmsg);
                                                txmsg = NULL;
                                                break;
                                            }
                                        }
                                        if (READY == res)
                                        {
                                            finish_tx(txmsg); // success
                                            txmsg = NULL;
                                        }
                                        else    // echo mismatch
                                        {
                                            Serial.end();
                                            COOS_DELAY(random(10));
                                            Serial.begin(19200);
                                            COOS_DELAY(2);
                                        }
                                    } // if tx started
                                } // if pause on the bus
                            } // if txmsg
                        } // while txmsg
                        digitalWrite(LED, LOW);
                    } // if HBus message
                    // --------------------------------
                    // process received MQTT message
                    // --------------------------------
                    else
                    {
                        HBmqtt.rd_msg(rxmsg);           // if topic is in the GW own topic list - process it
                        rxmsg->busy = 0;
                    }
                } // if rxmsg
            }
        } // while Serial.available
        // -----------------------------------------------
        // Broadcast MQTT-SN messages to the bus
        // -----------------------------------------------
        if (HBmqtt.mqmsg.valid)
        {
            txmsg = &HBmqtt.mqmsg;
            txmsg->busy = 1;
            if (txmsg->encrypt) // if message to be encrypted
            {
                HBcipher.encrypt(txmsg->buf, txmsg->len);
            }
            HBrxtx.rtr_cnt = 0;
            while(txmsg)
            {
                if (HBrxtx.rtr_cnt++ > 2)
                {
                    finish_tx(txmsg);
                    txmsg = NULL;
                }
                if (txmsg)
                {
                    tmout = 0;
                    HBrxtx.priority = 0xFF;
                    while (hb_pause_cnt < 2)
                    {
                        COOS_DELAY(1);
                        clr_rx();           // receiver must be empty
                        if (++tmout > 200)  // time-out 200 ms
                        {
                            finish_tx(txmsg);
                            txmsg = NULL;
                            break;
                        }
                    }
                    if ((txmsg) && (hb_pause_cnt >= 2))
                    {
                        if (OK == HBrxtx.start_tx(txmsg))
                        {
                            res = NOT_READY;
                            tmout = 0;
                            while (NOT_READY == res)
                            {
                                COOS_DELAY(1);
                                res = HBrxtx.tx(&hb_pause_cnt);
                                if (++tmout > 200)
                                {
                                    finish_tx(txmsg);
                                    txmsg = NULL;
                                    break;
                                }
                            }
                            if (READY == res)
                            {
                                finish_tx(txmsg); // success
                                txmsg = NULL;
                            }
                            else    // echo mismatch
                            {
                                Serial.end();
                                COOS_DELAY(random(10));
                                Serial.begin(19200);
                                COOS_DELAY(2);
                            }
                        } // if tx started
                    }
                }
            }  // while txmsg
            HBmqtt.mqmsg.busy = 0;   // ensure
            HBmqtt.mqmsg.valid = 0;
        } // if mqmsg.valid
    }
}

// =============================================================================
// Task: tick 1 ms
// =============================================================================
void coos_task_tick1ms(void)
{
    static uchar cnt;
    while(1)
    {
        COOS_DELAY(1);
        if (hb_pause_cnt < 200)
        {
            hb_pause_cnt++;
        }
        if (++cnt >= 10)
        {
            cnt = 0;
            HBcmd.tick10ms();
        }
    }
}


/* EOF */
