akouz/HBus/HBnodeMiniPro/HBcmd.cpp

/*
 * File     HBcmd.cpp
 
 * (c) 2023 Alex Kouznetsov,  https://github.com/akouz/hbus
 *
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
 * The above copyright notice and this permission notice shall be included in
 * all copies or substantial portions of the Software.
 *                                                                                                                                                                        F
 * THE SOFTWARE IS PROVIDED "AS IS", WITHOUT WARRANTY OF ANY KIND, EXPRESS OR
 * IMPLIED, INCLUDING BUT NOT LIMITED TO THE WARRANTIES OF MERCHANTABILITY,
 * FITNESS FOR A PARTICULAR PURPOSE AND NONINFRINGEMENT. IN NO EVENT SHALL THE
 * AUTHORS OR COPYRIGHT HOLDERS BE LIABLE FOR ANY CLAIM, DAMAGES OR OTHER
 * LIABILITY, WHETHER IN AN ACTION OF CONTRACT, TORT OR OTHERWISE, ARISING FROM,
 * OUT OF OR IN CONNECTION WITH THE SOFTWARE OR THE USE OR OTHER DEALINGS IN THE
 * SOFTWARE.
 */

//##############################################################################
// Inc
//##############################################################################

#include  "HBmqtt.h"
#include  "HBcmd.h"
#include  "HBcipher.h"

//##############################################################################
// Var
//##############################################################################

HB_cmd HBcmd;

#ifdef DEVICE_DESCRIPTION
    const char fixed_descr[] = DEVICE_DESCRIPTION;
#endif

//##############################################################################
// Func
//##############################################################################

// =====================================
// Constructor
// =====================================
HB_cmd::HB_cmd(void)
{
    this->ignore_collect = 0;
    this->ignore_traffic = 0;
    this->cmd_reply.len = 0;
    this->cmd_reply.all = 0;
    this->own.ID = 0;
    this->custom_cmd = NULL;
}

// =====================================
// Init own ID when EEPROM started
// =====================================
void HB_cmd::read_own_ID(void)
{
#ifdef DEVICE_ID
    this->own.id[0] = (uchar)DEVICE_ID;
    this->own.id[1] = (uchar)(DEVICE_ID >> 8);
#else
    this->own.id[0] = EEPROM.read(EE_OWN_ID + 1);   // LSB
    this->own.id[1] = EEPROM.read(EE_OWN_ID);       // MSB
#endif
}

// =====================================
// Read security settings from EEPROM
// =====================================
void HB_cmd::read_security(uchar key_valid)
{
    this->allow.all = 0xFFFF;    // default: enable unecrypted access
    HBmqtt.allow.all = 0xFFFF;
    if ((key_valid) && (this->own.ID < 0x800))  // if key valid and permanent NodeID assigned
    {
        uint val = 0x100*(uint)EEPROM.read(EE_SECURITY);
        val +=(uchar)EEPROM.read(EE_SECURITY+1);
        uint notval = 0x100*(uint)EEPROM.read(EE_SECURITY_INV);
        notval += (uchar)EEPROM.read(EE_SECURITY_INV+1);
        notval = (~notval) & 0xFFFF;
        if (val == notval)              // if direct and inverted values are the same
        {
            this->allow.all = val;      // HBus mode settings
            HBmqtt.allow.all = val;     // MQTT mode settings
        }
    }
}

// =====================================
// Process input commands, form a reply if required
// =====================================
hb_tx_msg_t* HB_cmd::process_rx_cmd(hb_msg_t* rxmsg)
{
    uchar cmd;
    uchar res = 0; // no reply
    if ((rxmsg) && (this->cmd_reply.busy == 0) && (rxmsg->hb) && (rxmsg->len >= 12))
    {
        this->cmd_reply.hb = rxmsg->hb;
        cmd = rxmsg->buf[0];
        // ----------------------------
        // reply to COLLECT command
        // ----------------------------
        if ((cmd == CMD_COLLECT) && (this->ignore_collect == 0))
        {
            if ((rxmsg->encrypt) || (this->allow.collect))
            {
                if ((this->allow.ignore_ts) || (rxmsg->ts_ok) || (!rxmsg->encrypt))  // timestamp
                {
                    res = rply_collect(rxmsg, &cmd_reply);
                    rxmsg->busy = 0;
                    return &cmd_reply;
                }
            }
        }
        // ----------------------------
        // if ID (eg address) matches
        // ----------------------------
        else if ((rxmsg->buf[3] == own.id[1]) && (rxmsg->buf[4] == own.id[0]))
        {
            if ((this->allow.ignore_ts) || (rxmsg->ts_ok) || (!rxmsg->encrypt))  // timestamp
            {
                this->cmd_reply.hb = rxmsg->hb;
                this->cmd_reply.encrypt = rxmsg->encrypt;
                begin_txmsg(&this->cmd_reply, rxmsg->hb);
                this->cmd_reply.postpone = 0;
                switch(cmd)
                {
                    case CMD_REV:       res = rply_rev(rxmsg, &this->cmd_reply);      break;
                    case CMD_STATUS:    res = rply_status(rxmsg, &this->cmd_reply);   break;
                    case CMD_PING:      res = rply_ping(rxmsg, &this->cmd_reply);     break;
                    case CMD_SET_ID:    res = rply_setID(rxmsg, &this->cmd_reply);    break;
                    case CMD_BOOT:      res = rply_boot(rxmsg, &this->cmd_reply);     break;
                    case CMD_BEEP:      res = rply_beep(rxmsg, &this->cmd_reply);     break;
                    case CMD_DESCR:     res = rply_descr(rxmsg, &this->cmd_reply);    break;
                    case CMD_SECURITY:  res = rply_security(rxmsg, &this->cmd_reply); break;
                    case CMD_CUSTOM:    res = rply_custom(rxmsg, &this->cmd_reply);   break;
                    case CMD_TOPIC:     res = rply_topic(rxmsg, &this->cmd_reply);    break;
                    default:            res = rply_unknown(rxmsg, &this->cmd_reply);  break;
                }
                if (READY == res)
                {
                    if (OK == finish_txmsg(&cmd_reply))
                    {
                        rxmsg->busy = 0;
                        rxmsg = NULL;
                        return &cmd_reply;
                    }
                }
            }
        }
        // ----------------------------
        // react to BOOT to another node
        // ----------------------------
        else if (cmd == CMD_BOOT)
        {
            if ((this->allow.ignore_ts) || (rxmsg->ts_ok))  // timestamp
            {
                alien_boot(rxmsg);
            }
        }
    }
    rxmsg->busy = 0;
    return NULL;
}

// =====================================
// Unknown command
// =====================================
uchar HB_cmd::rply_unknown(hb_msg_t* rxmsg, hb_tx_msg_t* rply)
{
    if (!rxmsg->encrypt)
    {
        copy_msg_hdr(rxmsg, 0, 6, rply);
        add_txmsg_uchar(rply, random(0x100));  // nonce
        add_txmsg_uchar(rply,  ERR_UNKNOWN);
        add_ts(rply);   // timestamp
        return READY;
    }
    return ERR_SECURITY; // do not reply to unknown encrypted commands
}

// =====================================
// Reply revisions
// =====================================
uchar HB_cmd::rply_rev(hb_msg_t* rxmsg, hb_tx_msg_t* rply)
{
    if ((rxmsg->encrypt) || (this->allow.rev))
    {
        copy_msg_hdr(rxmsg, 0, 6, rply);
        add_txmsg_uchar(rply, random(0x100));   // nonce
        add_txmsg_uchar(rply,  OK);
        add_ts(rply);                           // timestamp
        add_txmsg_uchar(rply, HB_DEV_TYPE);
        add_txmsg_uchar(rply, HB_DEV_MODEL);
        add_txmsg_uchar(rply, HB_HW_REV_MAJ);
        add_txmsg_uchar(rply, HB_HW_REV_MIN);
        add_txmsg_uchar(rply, HB_BOOT_REV_MAJ);
        add_txmsg_uchar(rply, HB_BOOT_REV_MIN);
        add_txmsg_uchar(rply, HB_SKETCH_REV_MAJ);
        add_txmsg_uchar(rply, HB_SKETCH_REV_MIN);
        add_txmsg_uchar(rply, HB_REV_MAJ);      // HBus revision
        add_txmsg_uchar(rply, HB_REV_MIN);
        return READY;
    }
    return ERR_SECURITY;
}
// =====================================
// Reply status
// =====================================
uchar HB_cmd::rply_status(hb_msg_t* rxmsg, hb_tx_msg_t* rply)
{
    char buf[0x80];
    if ((rxmsg->encrypt) || (this->allow.status))
    {
        uint tpc;
        copy_msg_hdr(rxmsg, 0, 6, rply);
        add_txmsg_uchar(rply, random(0x100));  // nonce
        if (DF_STATUS == 1) // DF = JSON
        {
            add_txmsg_uchar(rply,  DF_STATUS);
            add_ts(rply);   // timestamp
            // list all topics
            snprintf(buf, sizeof(buf),"{tid:[");
            add_txmsg_z_str(rply, buf);
            buf[0] = 0;
            for (uchar i=0; i< MAX_TOPIC; i++)
            {
                if (HBmqtt.flag[i].topic_name)
                {
                    if (buf[0])
                    {
                        add_txmsg_uchar(rply, uchar(',')); // add comma between items
                    }
                    tpc = ownTopicId[i];
                    snprintf(buf, sizeof(buf),"%d", tpc);
                    add_txmsg_z_str(rply, buf);
                }
            }
            // list all topics values
            snprintf(buf, sizeof(buf),"], val:[");
            add_txmsg_z_str(rply, buf);
            buf[0] = 0;
            for (uchar i=0; i<MAX_TOPIC; i++)
            {
                if (HBmqtt.flag[i].topic_name)
                {
                    if (buf[0])
                    {
                        add_txmsg_uchar(rply, uchar(',')); // add comma between items
                    }
                    HBmqtt.print_own_val(i, buf);
                    add_txmsg_z_str(rply, buf);
                }
            }
            add_txmsg_uchar(rply, ']');
            add_txmsg_uchar(rply, '}');
        }
        else // DF = binary, other formats not implemented yet
        {
            add_txmsg_uchar(rply,  0); // 0 = binary data
            add_ts(rply);   // timestamp
            add_txmsg_uchar(rply, MAX_TOPIC);
            for (uchar i=0; i<MAX_TOPIC; i++)
            {
                tpc = ownTopicId[i];
                add_txmsg_uchar(rply, (uchar)(tpc >> 8));
                add_txmsg_uchar(rply, (uchar)tpc);
            }
        }
        return READY;
    }
    return ERR_SECURITY;
}

// =====================================
// Reply COLLECT
// =====================================
uchar HB_cmd::rply_collect(hb_msg_t* rxmsg, hb_tx_msg_t* rply)
{
    uchar grp = rxmsg->buf[3];
    uchar res = 0;
    // -----------------------------
    // check group
    // -----------------------------
    switch (grp)
    {
        case 1: // all nodes
            res = READY;
            break;
        case 2: // nodes with tmp ID
            res = ((own.ID & 0xF000) == 0xF000)? READY : NOT_READY;
            break;
        case 3: // nodes with permanent ID
            res = ((own.ID & 0xF000) == 0xF000)? NOT_READY : READY;
            break;
        default:
            break;
    }
    // -----------------------------
    // if reply required
    // -----------------------------
    uchar slots = rxmsg->buf[4];
    if (READY == res)
    {
        rply->postpone = random(slots);
        cmd_reply.hb = rxmsg->hb;
        cmd_reply.encrypt = rxmsg->encrypt;
        begin_txmsg(&cmd_reply, rxmsg->hb);
        copy_msg_hdr(rxmsg, 0, 3, rply);
        add_txmsg_uchar(rply, own.id[1]);
        add_txmsg_uchar(rply, own.id[0]);
        copy_msg_hdr(rxmsg, 5, 6, rply);
        add_txmsg_uchar(rply, random(0x100)); // nonce
        add_txmsg_uchar(rply, OK);
        add_ts(rply);   // timestamp
        finish_txmsg(&cmd_reply);
    }
    else
    {
        rply->postpone = slots;
        rply->len = 0;
        res = READY;
    }
    return res;
}

// =====================================
// Reply PING
// =====================================
uchar HB_cmd::rply_ping(hb_msg_t* rxmsg, hb_tx_msg_t* rply)
{
    if ((rxmsg->encrypt) || (this->allow.ping))
    {
        ignore_collect = (uint)rxmsg->buf[7]*100;
        copy_msg_hdr(rxmsg, 0, 6, rply);
        add_txmsg_uchar(rply, random(0x100));  // nonce
        add_txmsg_uchar(rply,  OK);
        add_ts(rply);   // timestamp
        return READY;
    }
    return ERR_SECURITY;
}

// =====================================
// Reply SET_ID
// =====================================
#define MAGIC_ID 0x07FA
uchar HB_cmd::rply_setID(hb_msg_t* rxmsg, hb_tx_msg_t* rply)
{
    uint id = ((uint)rxmsg->buf[12] << 8) | rxmsg->buf[13];
    if ((own.ID >= 0xF000) || (id == MAGIC_ID)) // only tmp ID can be set, or if the 'magic' value presented
    {
        if ((HBcipher.valid == 0) || (rxmsg->encrypt))
        {
            uchar res = ERR;
            if (rxmsg->len > 12)
            {
                if (id == MAGIC_ID)
                {
                    own.id[1] = 0xF7;
                    own.id[0] = 0xFA;
                    this->allow.all = 0xFFFF;
                }
                else
                {
                    own.id[1] = rxmsg->buf[12];
                    own.id[0] = rxmsg->buf[13];
                }
                EEPROM.write(EE_OWN_ID, own.id[1]);
                EEPROM.write(EE_OWN_ID+1, own.id[0]);
                res = OK;
            }
            copy_msg_hdr(rxmsg, 0, 3, rply);
            add_txmsg_uchar(rply, own.id[1]);
            add_txmsg_uchar(rply, own.id[0]);
            copy_msg_hdr(rxmsg, 5, 6, rply);
            add_txmsg_uchar(rply, random(0x100));  // nonce
            add_txmsg_uchar(rply,  res);
            add_ts(rply);   // timestamp
            return READY;
        }
    }
    return ERR_SECURITY;
}

// =====================================
// Reply BOOT
// =====================================
uchar HB_cmd::rply_boot(hb_msg_t* rxmsg, hb_tx_msg_t* rply)
{
    if ((rxmsg->encrypt) || (this->allow.boot))
    {
        copy_msg_hdr(rxmsg, 0, 6, rply);
        add_txmsg_uchar(rply, random(0x100));  // nonce
        add_txmsg_uchar(rply,  OK);
        add_ts(rply);   // timestamp
        return READY;
    }
    return ERR_SECURITY;
}

// =====================================
// React to alien BOOT
// =====================================
void HB_cmd::alien_boot(hb_msg_t* rxmsg)
{
    if ((rxmsg->encrypt) || (this->allow.boot))
    {
        uint param = (uint)rxmsg->buf[7];
        this->ignore_traffic = param*100;
    }
}

// =====================================
// Reply BEEP
// =====================================
uchar HB_cmd::rply_beep(hb_msg_t* rxmsg, hb_tx_msg_t* rply)
{
    if ((rxmsg->encrypt) || (this->allow.ping))
    {
        blink((uint)rxmsg->buf[7]*100);
        copy_msg_hdr(rxmsg, 0, 6, rply);
        add_txmsg_uchar(rply, random(0x100));  // nonce
        add_txmsg_uchar(rply,  OK);
        add_ts(rply);   // timestamp
        return READY;
    }
    return ERR_SECURITY;
}

// =====================================
// Reply DESCR
// =====================================
uchar HB_cmd::rply_descr(hb_msg_t* rxmsg, hb_tx_msg_t* rply)
{
    uchar len, rdwr;
    copy_msg_hdr(rxmsg, 0, 6, rply);
    add_txmsg_uchar(rply, random(0x100));  // nonce
    rdwr = rxmsg->buf[7];
    // ----------------------
    // write
    // ----------------------
    if ((rdwr) && (rxmsg->len > 12))
    {
#ifdef DEVICE_DESCRIPTION
        add_txmsg_uchar(rply,  ERR);    // cannot write, description is fixed, it is defined in "HBconfig.h"
        return READY;
#else
        if ((rxmsg->encrypt) || (this->allow.wrdescr))
        {
            len = rxmsg->buf[12];
            if (len < 64)
            {
                add_txmsg_uchar(rply,  OK);
                add_ts(rply);   // timestamp
                EEPROM.write(EE_DESCR, len);
                for (uchar i=0; i<len; i++)
                {
                    EEPROM.write(EE_DESCR+1+i, rxmsg->buf[13+i]);
                }
            }
            else
            {
                add_txmsg_uchar(rply,  ERR);
            }
            return READY;
        }
#endif
    }
    // ----------------------
    // read
    // ----------------------
    else
    {
        if ((rxmsg->encrypt) || (this->allow.rddescr))
        {
            add_txmsg_uchar(rply,  OK);
            add_ts(rply);   // timestamp
#ifdef DEVICE_DESCRIPTION
            len = sizeof(fixed_descr);
#else
            len = EEPROM.read(EE_DESCR);
#endif
            len = (len < 64)? len : 0;
            add_txmsg_uchar(rply,  len);
            if (len)
            {
                for (uchar i=0; i<len; i++)
                {
#ifdef DEVICE_DESCRIPTION
                    add_txmsg_uchar(rply, fixed_descr[i]);
#else
                    add_txmsg_uchar(rply, EEPROM.read(EE_DESCR+1+i));
#endif
                }
            }
            return READY;
        }
    }
    return ERR_SECURITY;
}

// =====================================
// EEPROM cipher and access control settings
// =====================================
uchar HB_cmd::rply_security(hb_msg_t* rxmsg, hb_tx_msg_t* rply)
{
    uchar rdwr = rxmsg->buf[7];
    // ----------------------
    // store
    // ----------------------
    if ((rdwr) && (rxmsg->len > 9))
    {
        if ((rxmsg->encrypt) || (!HBcipher.valid))
        {
            copy_msg_hdr(rxmsg, 0, 6, rply);
            add_txmsg_uchar(rply, random(0x100));  // nonce
            // store unencrypted access settings
            uint newval = 0x100*rxmsg->buf[12] + rxmsg->buf[13];
            if (newval != this->allow.all)  // if new settings are differend
            {
                EEPROM.write(EE_SECURITY, rxmsg->buf[12]);
                EEPROM.write(EE_SECURITY+1, rxmsg->buf[13]);
                EEPROM.write(EE_SECURITY_INV, (uchar)(~rxmsg->buf[12]));
                EEPROM.write(EE_SECURITY_INV+1, (uchar)(~rxmsg->buf[13]));
            }
            // store EEPROM key
            if (rxmsg->len > 20) // new cipher supplied
            {
                if (HBcipher.valid == 0) // stored cipher is blank
                {
                    for (uchar i=0; i<4; i++) // 4 keys
                    {
                        for (uchar j=0; j<4; j++) // 4 bytes each
                        {
                            // reverse byte order in every key
                            EEPROM.write(EE_XTEA_KEY + 4*i + j, rxmsg->buf[14 + 4*i + 3-j]);
                        }
                    }
                    HBcipher.get_EE_key();  // restore new keys from EEPROM
                    read_security(HBcipher.valid);
                    add_txmsg_uchar(rply, OK);
                    add_ts(rply);   // timestamp
                    add_txmsg_uchar(rply, (uchar)(this->allow.all >> 8));
                    add_txmsg_uchar(rply, (uchar)this->allow.all);
                    return READY;
                }
                else
                {
                    add_txmsg_uchar(rply, ERR); // cannot rewrite valid cipher
                }
            }
            else if (rxmsg->len == 10) // header + access_settings
            {
                add_txmsg_uchar(rply, OK);
                add_ts(rply);   // timestamp
            }
            else
            {
                add_txmsg_uchar(rply, ERR_PARAM); // wrong length
                add_ts(rply);   // timestamp
            }
            read_security(HBcipher.valid);
            add_txmsg_uchar(rply, (uchar)(this->allow.all >> 8));
            add_txmsg_uchar(rply, (uchar)this->allow.all);
            return READY;
        }
        return ERR_SECURITY;
    }
    // ----------------------
    // read
    // ----------------------
    else
    {
        if ((rxmsg->encrypt) || (this->allow.rdsecurity))
        {
            copy_msg_hdr(rxmsg, 0, 6, rply);
            add_txmsg_uchar(rply, random(0x100));  // nonce
            add_txmsg_uchar(rply, OK);
            add_ts(rply);   // timestamp
            add_txmsg_uchar(rply, (uchar)(this->allow.all >> 8));
            add_txmsg_uchar(rply, (uchar)this->allow.all);
            return READY;
        }
        return ERR_SECURITY;
    }
    return ERR_PARAM;
}

// =====================================
// Reply C_CMD
// =====================================
uchar HB_cmd::rply_custom(hb_msg_t* rxmsg, hb_tx_msg_t* rply)
{
    if ((rxmsg->encrypt) || (this->allow.customcmd))
    {
        copy_msg_hdr(rxmsg, 0, 6, rply);
        add_txmsg_uchar(rply, random(0x100));  // nonce
        if (custom_cmd)
        {
            add_txmsg_uchar(rply,  OK);
            add_ts(rply);   // timestamp
            rply = custom_cmd(rxmsg);        // whatever defined
        }
        else
        {
            add_txmsg_uchar(rply,  ERR);    // custom command not defined
            add_ts(rply);   // timestamp
        }
        return READY;
    }
    return ERR_SECURITY;
}


// =====================================
// Set custom command
// =====================================
void HB_cmd::set_custom_cmd(hb_tx_msg_t* (*c_cmd)(hb_msg_t* msg))
{
    custom_cmd = c_cmd;   // set user-defined custom command
}

// =====================================
// Reply topic, eg pair TopicId + TopicName
// =====================================
uchar  HB_cmd::rply_topic(hb_msg_t* rxmsg, hb_tx_msg_t* rply)
{
    if ((rxmsg->encrypt) || (this->allow.topic))
    {
        copy_msg_hdr(rxmsg, 0, 6, rply);        // header
        add_txmsg_uchar(rply, random(0x100));   // nonce
        uchar ti = rxmsg->buf[7];               // get topic index
        if (HBmqtt.flag[ti].topic_name)
        {
            add_txmsg_uchar(rply, OK);
            add_ts(rply);                       // timestamp
            add_txmsg_uchar(rply, (uchar)(ownTopicId[ti] >> 8));
            add_txmsg_uchar(rply, (uchar)ownTopicId[ti]);
            char buf[0x40];
            uchar len = copy_topic(ti, buf);
            for (uchar i=0; i<len; i++)
            {
                add_txmsg_uchar(rply, (char)buf[i]);
            }
        }
        else
        {
            add_txmsg_uchar(rply, ERR);
            add_ts(rply);                       // timestamp
        }
        return READY;
    }
    return ERR_SECURITY;
}


// =====================================
// Every 10 ms
// =====================================
void HB_cmd::tick10ms(void)
{
    if (ignore_traffic)
    {
        ignore_traffic--;
    }
    if (ignore_collect)
    {
        ignore_collect--;
    }
    if (led_cnt)
    {
        led_cnt--;
        if (led_cnt == 0)
        {
            digitalWrite(LED_BUILTIN, LOW);
        }
    }
}

/* EOF */
