akouz/HBus/HBnodeMiniPro/HBcommon.cpp

/*
 * File     common.cpp
 
 * (c) 2023 Alex Kouznetsov,  https://github.com/akouz/hbus
 *
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
 * THE SOFTWARE IS PROVIDED "AS IS", WITHOUT WARRANTY OF ANY KIND, EXPRESS OR
 * IMPLIED, INCLUDING BUT NOT LIMITED TO THE WARRANTIES OF MERCHANTABILITY,
 * FITNESS FOR A PARTICULAR PURPOSE AND NONINFRINGEMENT. IN NO EVENT SHALL THE
 * AUTHORS OR COPYRIGHT HOLDERS BE LIABLE FOR ANY CLAIM, DAMAGES OR OTHER
 * LIABILITY, WHETHER IN AN ACTION OF CONTRACT, TORT OR OTHERWISE, ARISING FROM,
 * OUT OF OR IN CONNECTION WITH THE SOFTWARE OR THE USE OR OTHER DEALINGS IN THE
 * SOFTWARE.
 */

//##############################################################################
// Inc
//##############################################################################

#include  "HBcommon.h"

//##############################################################################
// Var
//##############################################################################

uint pup_cnt;
uint node_seed;
uint led_cnt;     // until LED switched off, in 10 ms ticks

StaticJsonBuffer <128> jsonBuf;

Coos <COOS_TASKS, 1> coos;  // declare cooperative operating system

// char tmp_str[0x20];

//uint tag[2];

//##############################################################################
// Func
//##############################################################################

// =============================================
// Blink LED
// =============================================
void blink(uint dur) // 10ms ticks
{
    led_cnt = dur;
//    digitalWrite(LED_BUILTIN, HIGH);
    digitalWrite(LED, HIGH);
}

// ========================================
// Debug: print hex value
// ========================================
uchar print_val(uchar val, uchar i)
{
#ifdef DEBUG
    if (val < 0x10)
        Serial.print(F("0"));
    Serial.print(val, HEX);
    Serial.print(F(" "));
    if ((i & 7) == 7)
        Serial.print(F(" "));
    if ((i & 0x1F) == 0x1F)
    {
        Serial.println();
        return 1;
    }
    else
    {
        return 0;
    }
#else
    return 0;
#endif
}

// =====================================
// Debug: print buf
// =====================================
void printbuf(uchar* buf, uchar len)
{
#ifdef DEBUG
    if ((buf) && (len))
    {
        Serial.print(F(" printing buf, len="));
        Serial.println(len);
        for (uchar i=0; i<len; i++)
        {
            if (buf[i] < 0x10)
              Serial.print(F("0"));
            Serial.print(buf[i], HEX);
            Serial.print(F(" "));
            if ((i & 7) == 7)
            {
                Serial.print(F(" "));
            }
            if ((i & 0x0F) == 0x0F)
            {
                Serial.println();
            }
        }
        Serial.println();
    }
#endif
}

// ========================================
// Debug: print message buffer
// ========================================
void print_buf(const char* name, hb_msg_t* msg)
{
#ifdef DEBUG
    uchar nl = 1;
    Serial.println();
    Serial.print(name);
    Serial.print(F(":"));
    if (msg->hb)
        Serial.print(F(" hbus"));
    else
        Serial.print(F(" mqtt"));
    if (msg->busy)
        Serial.print(F(" busy"));
    if (msg->valid)
        Serial.print(F(" valid"));
    if (msg->esc)
        Serial.print(F(" esc"));
    if (msg->gate)
        Serial.print(F(" gate"));
    Serial.println();
    for (uchar i=0; i < msg->len; i++)
    {
        nl = print_val(msg->buf[i], i);
    }
    if (nl == 0)
        Serial.println();
#endif
}
// =============================================
// Copy buffer
// =============================================
void copy_buf(uchar* src, uchar* dst, uchar len)
{
    if (dst)
    {
        for (uchar i=0; i<len; i++)
        {
            dst[i] = (src)? src[i] : 0; // if src does not exist then fill dst by 0
        }
    }
}
// =============================================
// Reverse byte order
// =============================================
void rev_4_bytes(uchar* buf)
{
    uchar tmp;
    tmp = buf[0];
    buf[0] = buf[3];
    buf[3] = tmp;
    tmp = buf[1];
    buf[1] = buf[2];
    buf[2] = tmp;
}
// =============================================
// Shift buffer down
// =============================================
void shift_buf(uchar* buf, uchar pos, uchar len)
{
    if ((buf) && (pos) && (len))
    {
        for (uchar i=0; i<len; i++)
        {
            buf[i] = buf[i+pos];
        }
    }
}
// =============================================
// Add uchar value to crc
// =============================================
uint crc_add_uchar(uchar b, uint crcx)
{
    crcx ^= (uint)b << 8;
    for (uchar j=0; j<8; j++)
    {
        crcx = (crcx & 0x8000)? (0xFFFF & ((crcx << 1) ^ 0x1021)) : (0xFFFF & (crcx << 1));
    }
    return crcx;
}
// =============================================
 // Calculate CRC
// =============================================
/*
 * Name  : CRC-16 CCITT
 * Poly  : 0x1021    x^16 + x^12 + x^5 + 1
 * Init  : 0xFFFF
 * Revert: false
 * XorOut: 0x0000
 * Check : 0x3B0A ("123456789" hex)
 */
uint calc_crc(uchar* buf, uchar len)
{
    uint crcx = 0xFFFF;
    if ((buf) && (len))
    {
        for (uchar i=0; i<len; i++)
        {
            crcx = crc_add_uchar(buf[i], crcx);
        }
    }
    return crcx;
}
// =============================================
// Append txmsg with calculated crc
// =============================================
void crc_to_msg(hb_tx_msg_t* msg)
{
    if (msg)
    {
        msg->buf[msg->len++] = (uchar)(msg->crc >> 8);
        msg->buf[msg->len++] = (uchar)msg->crc;
    }
}
// =============================================
// Reset Tx buffer and start a new message
// =============================================
uchar begin_txmsg(hb_tx_msg_t* txmsg, uchar hb)
{
    if (txmsg->busy)
    {
        return NOT_READY;
    }
    else
    {
        txmsg->hb = (hb)? 1 : 0;
        txmsg->crc = 0xFFFF;    // init crc
        txmsg->len = 0;
        return READY;
    }
}
// =============================================
// Add char to Tx message
// =============================================
uchar add_txmsg_uchar(hb_tx_msg_t* txmsg, uchar c)
{
    if ((txmsg->len >= MAX_TX_BUF) || (txmsg->busy))
    {
        return ERR;
    }
    txmsg->crc = crc_add_uchar(c, txmsg->crc);   // calculate crc
    txmsg->buf[txmsg->len++] = c;
    return OK;
}
// =============================================
// Add 0-terminated string to Tx message
// =============================================
uchar add_txmsg_z_str(hb_tx_msg_t* txmsg, char* str)
{
    uchar res = 0;
    if (txmsg->busy == 0)
    {
        while (*str)
        {
            if (txmsg->len < MAX_TX_BUF)
            {
                add_txmsg_uchar(txmsg, (uchar)*str);
                str++;
                res++;
            }
            else
            {
                break;
            }
        }
    }
    return res;
}
// =============================================
// Copy message header
// =============================================
void copy_msg_hdr(hb_msg_t* src, uchar first, uchar last, hb_tx_msg_t* txmsg)
{
    for (uchar i=first; i<last; i++)
    {
        if (i == 0)
        {
            add_txmsg_uchar(txmsg, src->buf[0] | 0x80); // set "reply" flag
        }
        else
        {
            add_txmsg_uchar(txmsg, src->buf[i]);
        }
    }
}

// =============================================
// Add timestamp
// =============================================
void add_ts(hb_tx_msg_t* txmsg)
{
    union {
        ulong   ulo;
        uchar   uch[4];
    } tmp;
    tmp.ulo = coos.uptime;
    for (uchar i=0; i<4; i++)
    {
        add_txmsg_uchar(txmsg, tmp.uch[3-i]);
    }
}
// =============================================
// Finish Tx message
// =============================================
uchar finish_txmsg(hb_tx_msg_t* txmsg)
{
    if ((txmsg) && (txmsg->len < MAX_TX_BUF-1))
    {
        crc_to_msg(txmsg);
        txmsg->busy = 1;
        return OK;
    }
    return ERR;
}

// =====================================
// Check if received timestamp valid
// =====================================
uchar ts_valid(hb_msg_t* rxmsg)
{
    ulong ts = (ulong)rxmsg->buf[8] << 24;
    ts |= (ulong)rxmsg->buf[9] << 16;
    ts |= (uint)rxmsg->buf[10] << 8;
    ts |= rxmsg->buf[11];
    if ((ts < coos.uptime + TIME_TOLERANCE) && (ts > coos.uptime -TIME_TOLERANCE))
    {
        return 1;
    }
    else
    {
        return 0;
    }
}

// =============================================
// Bubble sort
// =============================================
uchar sort(uint* arr, uint len)
{
    uchar res = 0;
    for (uint i=len-1; i>0; i--)
    {
        for (uint j=0; j<i; j++)
        {
            if ((0xFFFF & arr[j]) > (0xFFFF & arr[j+1]))
            {
                uint tmp = arr[j] & 0xFFFF;
                arr[j] = arr[j+1] & 0xFFFF;
                arr[j+1] = tmp;
                res = 1;    // changes made
            }
        }
    }
    return res;
}

/* EOF */
