akouz/HBus/Devices/03_WiFi_Gateway/WiFiGw/HBmqtt.h

/*
 * file     HBmqtt.h 
 * Target   Arduino

 * (c) 2019 Alex Kouznetsov,  https://github.com/akouz/hbus
 *
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
 * THE SOFTWARE IS PROVIDED "AS IS", WITHOUT WARRANTY OF ANY KIND, EXPRESS OR
 * IMPLIED, INCLUDING BUT NOT LIMITED TO THE WARRANTIES OF MERCHANTABILITY,
 * FITNESS FOR A PARTICULAR PURPOSE AND NONINFRINGEMENT. IN NO EVENT SHALL THE
 * AUTHORS OR COPYRIGHT HOLDERS BE LIABLE FOR ANY CLAIM, DAMAGES OR OTHER
 * LIABILITY, WHETHER IN AN ACTION OF CONTRACT, TORT OR OTHERWISE, ARISING FROM,
 * OUT OF OR IN CONNECTION WITH THE SOFTWARE OR THE USE OR OTHER DEALINGS IN THE
 * SOFTWARE.
 */

#ifndef __HB_MQTT_H
#define __HB_MQTT_H

//##############################################################################
// Inc                                              
//##############################################################################

#include  "HBcommon.h"

//##############################################################################
// Def
//##############################################################################

#define   BROADCAST_TOPIC_NAME             // add tname="topic_name" to PUBLISH message

#define    MAX_TOPIC      32    

const char topic0[] = "nodes";              // number of nodes on HBus
const char topic1[] = "voltage/gw1/hbus";   // HBus supply voltage, V
const char topic2[] = "temperature/gw1";    // Gateway temperature, C  (BMx280)
const char topic3[] = "pressure/gw1";       // Gateaway atmosferic pressure, mbar (BMx280)    
const char topic4[] = "humidity/gw1";       // Gateway relative humidity, % (BME280)
const char topic5[] = "CO2/gw1";            // Gateway CO2 level, ppm (MH-Z19B)
const char topic6[] = "";
const char topic7[] = "";
const char topic8[] = "";
const char topic9[] = "";
const char topic10[] = "";
const char topic11[] = "";
const char topic12[] = "";
const char topic13[] = "";
const char topic14[] = "";
const char topic15[] = "";
const char topic16[] = "";
const char topic17[] = "";
const char topic18[] = "";
const char topic19[] = "";
const char topic20[] = "";
const char topic21[] = "";
const char topic22[] = "";
const char topic23[] = "";
const char topic24[] = "";
const char topic25[] = "";
const char topic26[] = "";
const char topic27[] = "";
const char topic28[] = "";
const char topic29[] = "";
const char topic30[] = "";
const char topic31[] = ""; 

enum{
    // MessageType
    MT_REGISTER     = 0x0A,
    MT_PUBLISH      = 0x0C,    
};

//##############################################################################
// Var
//##############################################################################

extern const char* ownTopicName[MAX_TOPIC];    
extern uint ownTopicId[MAX_TOPIC];         

//##############################################################################
// Class
//##############################################################################

union mq_valid_uni{
    uint all;
    struct{
        unsigned    value       : 1;
        unsigned    topic       : 1;
        unsigned    topic_name  : 1;
    };
};

class HB_mqtt{
    public:
                HB_mqtt(void);
    union{
        uint all;
        struct{
            unsigned                : 10;   // not used here, those flags for HBus mode
            unsigned    ignore_ts   : 1;    // ignore time stamp mismatch for encrypted messages
            unsigned                : 2;    // not used
            unsigned    publish     : 1;    // can read unencrypted PUBLISH
            unsigned    reg         : 1;    // can read unencrypted REGISTER
            unsigned    broadcast   : 1;    // broadcast unencrypted PUBLISH and REGISTER              
        };
    } allow;    // allowed unecrypted access        
    hb_msg_t    mqmsg;
    float       value[MAX_TOPIC];                       // topic values
    union mq_valid_uni   valid[MAX_TOPIC];              // set of flags
    char        rd_msg(hb_msg_t* msg);
    uchar       make_msg_reg(uchar ti);                 // make REGISTER message
    uchar       make_msg_publish(uint tid, uchar* buf, uchar len); // make PUBLISH message    
    mqtt_msg_t*  publish_own_val(uint idx);             // make PUBLISH message for own value    
    mqtt_msg_t*  make_msg_time(ulong atime);            // make PUBLISH message topic="time"
    uchar       make_msg_err(char* txt, uint errcode);  // make PUBLISH message topic="err"
    void        read_topic_id(void);                    // restorew TopicId from EEPROM
    uchar       init_topic_id(uint node_id);            // after power-up call this function  
                                                        // repeatedly until it returns OK
    void        add_signature(char* buf, uint* len);
    uchar       is_signature(char* buf);
    
    private:
    uint*       descriptor;                             // list of own topics 
    char        is_own_topic_name(const char* tn);
    char        is_own_topic_id(uint tid);
    mqtt_msg_t  brmsg;                                  // message for MQTT broker
    uint        MsgID; 
    ulong       MsgID_cnt;                              // count all received MQTT messages 
    uint        MsgID_err_cnt;
    void        get_MsgID(uchar msg_id);
    void        make_msg_header(uchar MsgType, uint tid); // make header
    char        mbuf[0x80];
#ifdef BROADCAST_TOPIC_NAME
    uchar       add_tname(uchar idx, char* buf);       // add topic name to the string
#endif     
};    

extern HB_mqtt HBmqtt;



#endif /* __HB_MQTT_H */
